coffee-and-telesense/PicoAPRS/kicad/firmware-edition/firmware-edition.kicad_pcb

## KiCad design kicad/firmware-edition/firmware-edition.kicad_pcb (2025-06-20)

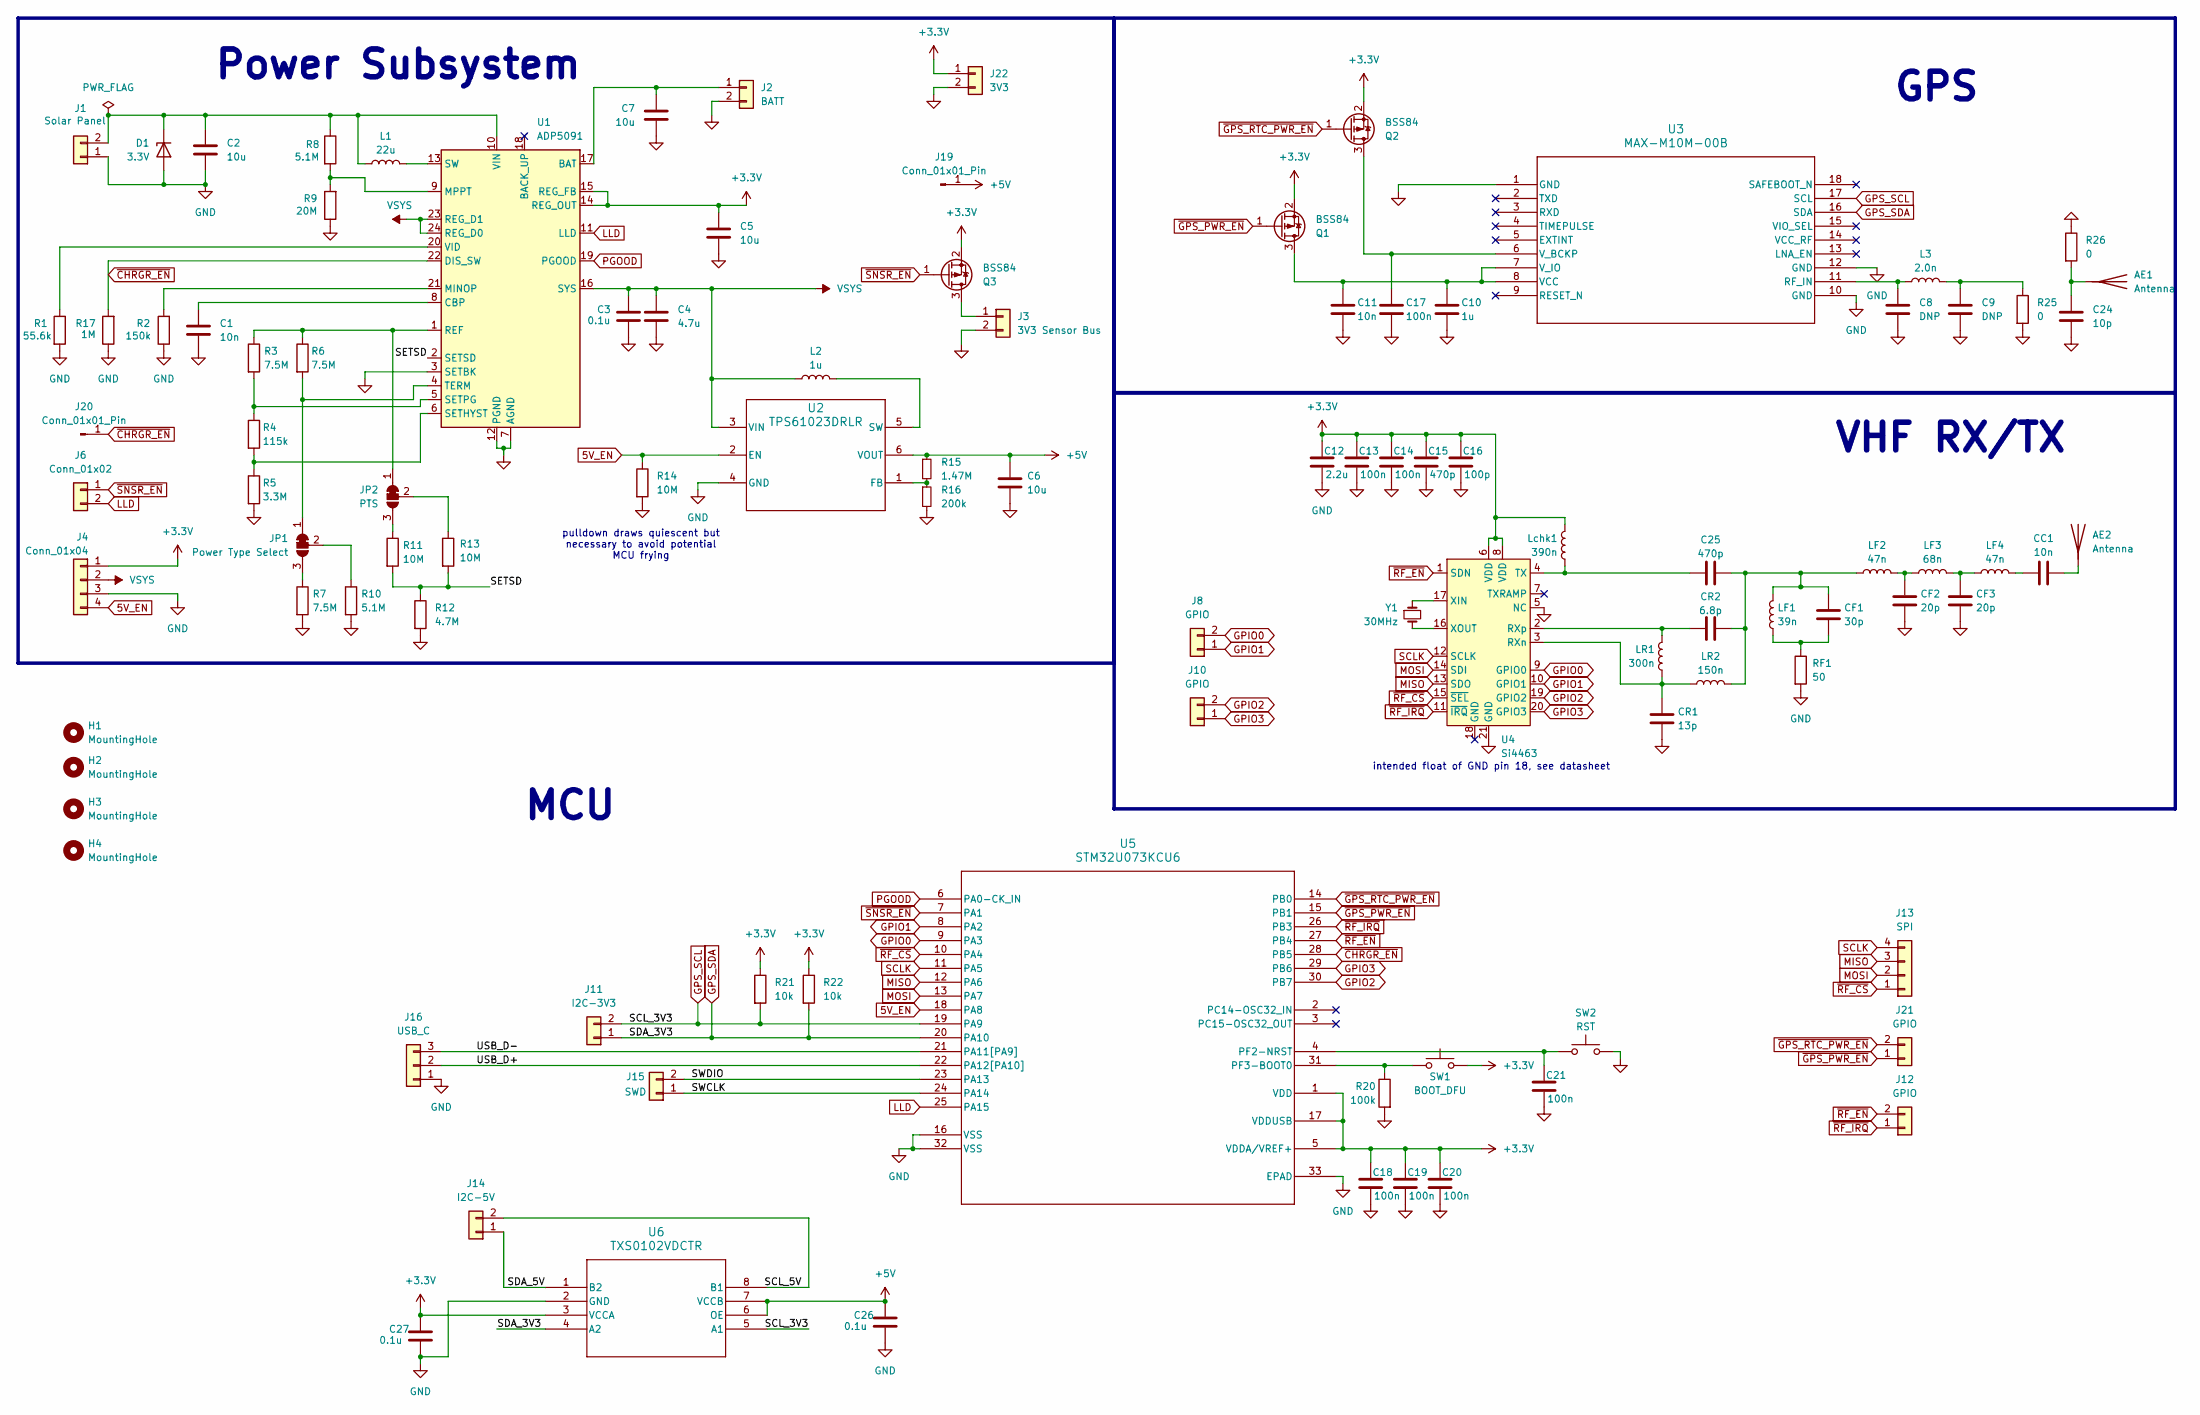
[picture p1: schematic firmware-edition.kicad_sch]

Parts:
AE1: Antenna; AC30157-01 GNSS Ceramic Chip
AE2: Antenna; SolderWirePad_1x01_SMD_1x2mm
C1, C11: 10n; C_0603_1608Metric
C2, C5, C6, C7: 10u; C_0603_1608Metric
C3, C26, C27: 0.1u; C_0603_1608Metric
C4: 4.7u; C_0603_1608Metric
C8, C9: DNP; C_0603_1608Metric
C10: 1u; C_0603_1608Metric
C12: 2.2u; C_0603_1608Metric
C13, C14, C17, C18, C19, C20, C21: 100n; C_0603_1608Metric
C15, C25: 470p; C_0603_1608Metric
C16: 100p; C_0603_1608Metric
C24: 10p; C_0603_1608Metric
CC1: 10n; C_0603_1608Metric
CF1: 30p; C_0603_1608Metric
CF2, CF3: 20p; C_0603_1608Metric
CR1: 13p; C_0603_1608Metric
CR2: 6.8p; C_0603_1608Metric
D1: 3.3V; D_0402_1005Metric_Pad0.77x0.64mm_HandSolder
H1, H2, H3, H4: MountingHole; MountingHole_3.2mm_M3_ISO14580
J1: Solar Panel; PinSocket_1x02_P2.54mm_Vertical
J2: BATT; PinSocket_1x02_P2.54mm_Vertical
J3: 3V3 Sensor Bus; PinSocket_1x02_P2.54mm_Vertical
J4: Conn_01x04; PinHeader_1x04_P2.54mm_Vertical
J6: Conn_01x02; PinHeader_1x02_P2.54mm_Vertical
J8, J10, J12, J21: GPIO; PinHeader_1x02_P2.54mm_Vertical
J11: I2C-3V3; PinHeader_1x02_P2.54mm_Vertical
J13: SPI; PinHeader_1x04_P2.54mm_Vertical
J14: I2C-5V; PinHeader_1x02_P2.54mm_Vertical
J15: SWD; PinHeader_1x02_P2.54mm_Vertical
J16: USB_C; PinHeader_1x03_P2.54mm_Vertical
J19, J20: Conn_01x01_Pin; PinHeader_1x01_P2.54mm_Vertical
J22: 3V3; PinSocket_1x02_P2.54mm_Vertical
JP1: Power Type Select; SolderJumper-3_P1.3mm_Bridged12_Pad1.0x1.5mm
JP2: PTS; SolderJumper-3_P1.3mm_Bridged12_Pad1.0x1.5mm
L1: 22u; L_Vishay_IFSC-1515AH_4x4x1.8mm
L2: 1u; L_0603_1608Metric
L3: 2.0n; L_0603_1608Metric
LF1: 39n; L_0603_1608Metric
LF2, LF4: 47n; L_0603_1608Metric
LF3: 68n; L_0603_1608Metric
LR1: 300n; L_0603_1608Metric
LR2: 150n; L_0603_1608Metric
Lchk1: 390n; L_0603_1608Metric
Q1, Q2, Q3: BSS84; SOT-23
R1: 55.6k; R_0603_1608Metric
R2: 150k; R_0603_1608Metric
R3, R6, R7: 7.5M; R_0603_1608Metric
R4: 115k; R_0603_1608Metric
R5: 3.3M; R_0603_1608Metric
R8, R10: 5.1M; R_0603_1608Metric
R9: 20M; R_0603_1608Metric
R11, R13, R14: 10M; R_0603_1608Metric
R12: 4.7M; R_0603_1608Metric
R15: 1.47M; R_0603_1608Metric
R16: 200k; R_0603_1608Metric
R17: 1M; R_0603_1608Metric
R20: 100k; R_0603_1608Metric
R21, R22: 10k; R_0603_1608Metric
R25, R26: 0; R_0603_1608Metric
RF1: 50; R_0603_1608Metric
SW1: BOOT_DFU; SW_Push_1TS009xxxx-xxxx-xxxx_6x6x5mm
SW2: RST; SW_Push_1TS009xxxx-xxxx-xxxx_6x6x5mm
U1: ADP5091; LFCSP-24-1EP_4x4mm_P0.5mm_EP2.3x2.3mm
U2: TPS61023DRLR; DRL0006A
U3: MAX-M10M-00B; MOD18_MAX-M10M_UBL
U4: Si4463; QFN-20-1EP_4x4mm_P0.5mm_EP2.6x2.6mm
U5: STM32U073KCU6; UFQFPN-32_STM
U6: TXS0102VDCTR; SSOP8_DCT_TEX
Y1: 30MHz; Crystal_SMD_Abracon_ABM3-2Pin_5.0x3.2mm

Connections:
5V_EN: J4.4, R14.1, U2.2 (EN), U5.18 (PA8)
+3.3V: C5.1, C12.1, C13.1, C14.1, C15.1, C16.1, C18.1, C19.1, C20.1, C27.1, J4.1, J22.1, Lchk1.1, Q1.2 (S), Q2.2 (S), Q3.2 (S), R21.1, R22.1, SW1.2, U1.14 (REG_OUT), U1.15 (REG_FB), U4.6 (VDD), U4.8 (VDD), U5.1 (VDD), U5.5 (VDDA/VREF+), U5.17 (VDDUSB), U6.3 (VCCA); also elsewhere on the board
+5V: C6.1, C26.1, J19.1, R15.1, U2.6 (VOUT), U6.6 (OE), U6.7 (VCCB)
/SCL_5V: J14.2, U6.8 (B1)
/SDA_5V: J14.1, U6.1 (B2)
/SETSD: R11.2, R12.1, R13.2, U1.2 (SETSD)
/SWCLK: J15.1, U5.24 (PA14)
/SWDIO: J15.2, U5.23 (PA13)
/USB_D+: J16.2, U5.22 (PA12[PA10])
/USB_D-: J16.3, U5.21 (PA11[PA9])
GND: C1.2, C2.2, C3.2, C4.2, C5.2, C6.2, C7.2, C8.2, C9.2, C10.2, C11.2, C12.2, C13.2, C14.2, C15.2, C16.2, C17.2, C18.2, C19.2, C20.2, C21.2, C24.2, C26.2, C27.2, CF2.2, CF3.2, CR1.2, D1.2 (A), J1.1, J2.2, J3.2, J4.3, J16.1, J22.2, R1.2, R2.1, R5.2, R7.2, R9.1, R10.2, R12.2, R14.2, R16.2, R17.1, R20.2, R25.2, R26.1, RF1.2, SW2.2, U1.3 (SETBK), U1.7 (AGND), U1.12 (PGND), U1.25 (AGND), U2.4 (GND), U3.1 (GND), U3.10 (GND), U3.12 (GND), U4.5 (NC), U4.21 (GND), U5.16 (VSS), U5.32 (VSS), U5.33 (EPAD), U5.34, U6.2 (GND); also elsewhere on the board
GPIO0: J8.2, U4.9 (GPIO0), U5.9 (PA3)
GPIO1: J8.1, U4.10 (GPIO1), U5.8 (PA2)
GPIO2: J10.2, U4.19 (GPIO2), U5.30 (PB7)
GPIO3: J10.1, U4.20 (GPIO3), U5.29 (PB6)
GPS_SCL: J11.2, R21.2, U3.17 (SCL), U5.19 (PA9), U6.5 (A1)
GPS_SDA: J11.1, R22.2, U3.16 (SDA), U5.20 (PA10), U6.4 (A2)
LLD: J6.2, U1.11 (LLD), U5.25 (PA15)
MISO: J13.3, U4.13 (SDO), U5.12 (PA6)
MOSI: J13.2, U4.14 (SDI), U5.13 (PA7)
unnamed: AE1.1 (A), C24.1, R26.2
unnamed: AE2.1 (A), CC1.2
unnamed: C9.1, L3.1, R25.1
unnamed: C25.2, CF1.1, CR2.2, LF1.2, LF2.1, LR2.2
unnamed: CC1.1, LF4.2
unnamed: CF1.2, LF1.1, RF1.1
unnamed: CF2.1, LF2.2, LF3.1
unnamed: CF3.1, LF3.2, LF4.1
unnamed: C2.1, D1.1 (K), J1.2, L1.1, R8.1, U1.10 (VIN)
unnamed: C7.1, J2.1, U1.17 (BAT)
unnamed: J3.1, Q3.3 (D)
unnamed: JP1.1 (A), R6.2, U1.4 (TERM)
unnamed: JP1.3 (B), R7.1
unnamed: JP1.2 (C), R10.1
unnamed: JP2.1 (A), R3.1, R6.1, U1.1 (REF)
unnamed: JP2.3 (B), R11.1
unnamed: JP2.2 (C), R13.1
unnamed: C10.1, C11.1, Q1.3 (D), U3.7 (V_IO), U3.8 (VCC)
unnamed: C17.1, Q2.3 (D), U3.6 (V_BCKP)
unnamed: C1.1, U1.8 (CBP)
unnamed: R2.2, U1.21 (MINOP)
unnamed: R8.2, R9.2, U1.9 (MPPT)
unnamed: R4.2, R5.1, U1.6 (SETHYST)
unnamed: R3.2, R4.1, U1.5 (SETPG)
unnamed: L1.2, U1.13 (SW)
unnamed: R1.1, U1.20 (VID)
unnamed: R15.2, R16.1, U2.1 (FB)
unnamed: L2.2, U2.5 (SW)
unnamed: C8.1, L3.2, U3.11 (RF_IN)
unnamed: CR1.1, LR1.2, LR2.1, U4.3 (RXn)
unnamed: CR2.1, LR1.1, U4.2 (RXp)
unnamed: C25.1, Lchk1.2, U4.4 (TX)
unnamed: U4.17 (XIN), Y1.1
unnamed: U4.16 (XOUT), Y1.2
unnamed: C21.1, SW2.1, U5.4 (PF2-NRST)
unnamed: R20.1, SW1.1, U5.31 (PF3-BOOT0)
PGOOD: U1.19 (PGOOD), U5.6 (PA0-CK_IN)
SCLK: J13.4, U4.12 (SCLK), U5.11 (PA5)
VSYS: C3.1, C4.1, J4.2, L2.1, U1.16 (SYS), U1.23 (REG_D1), U1.24 (REG_D0), U2.3 (VIN)
~CHRGR_EN: J20.1, R17.2, U1.22 (DIS_SW), U5.28 (PB5)
~GPS_PWR_EN: J21.1, Q1.1 (G), U5.15 (PB1)
~GPS_RTC_PWR_EN: J21.2, Q2.1 (G), U5.14 (PB0)
~RF_CS: J13.1, U4.15 (~SEL), U5.10 (PA4)
~RF_EN: J12.2, U4.1 (SDN), U5.27 (PB4)
~RF_IRQ: J12.1, U4.11 (~IRQ), U5.26 (PB3)
~SNSR_EN: J6.1, Q3.1 (G), U5.7 (PA1)

Notes on the sheet:
intended float of GND pin 18, see datasheet
GPS
Power Subsystem
MCU
VHF RX/TX
pulldown draws quiescent but necessary to avoid potential MCU frying

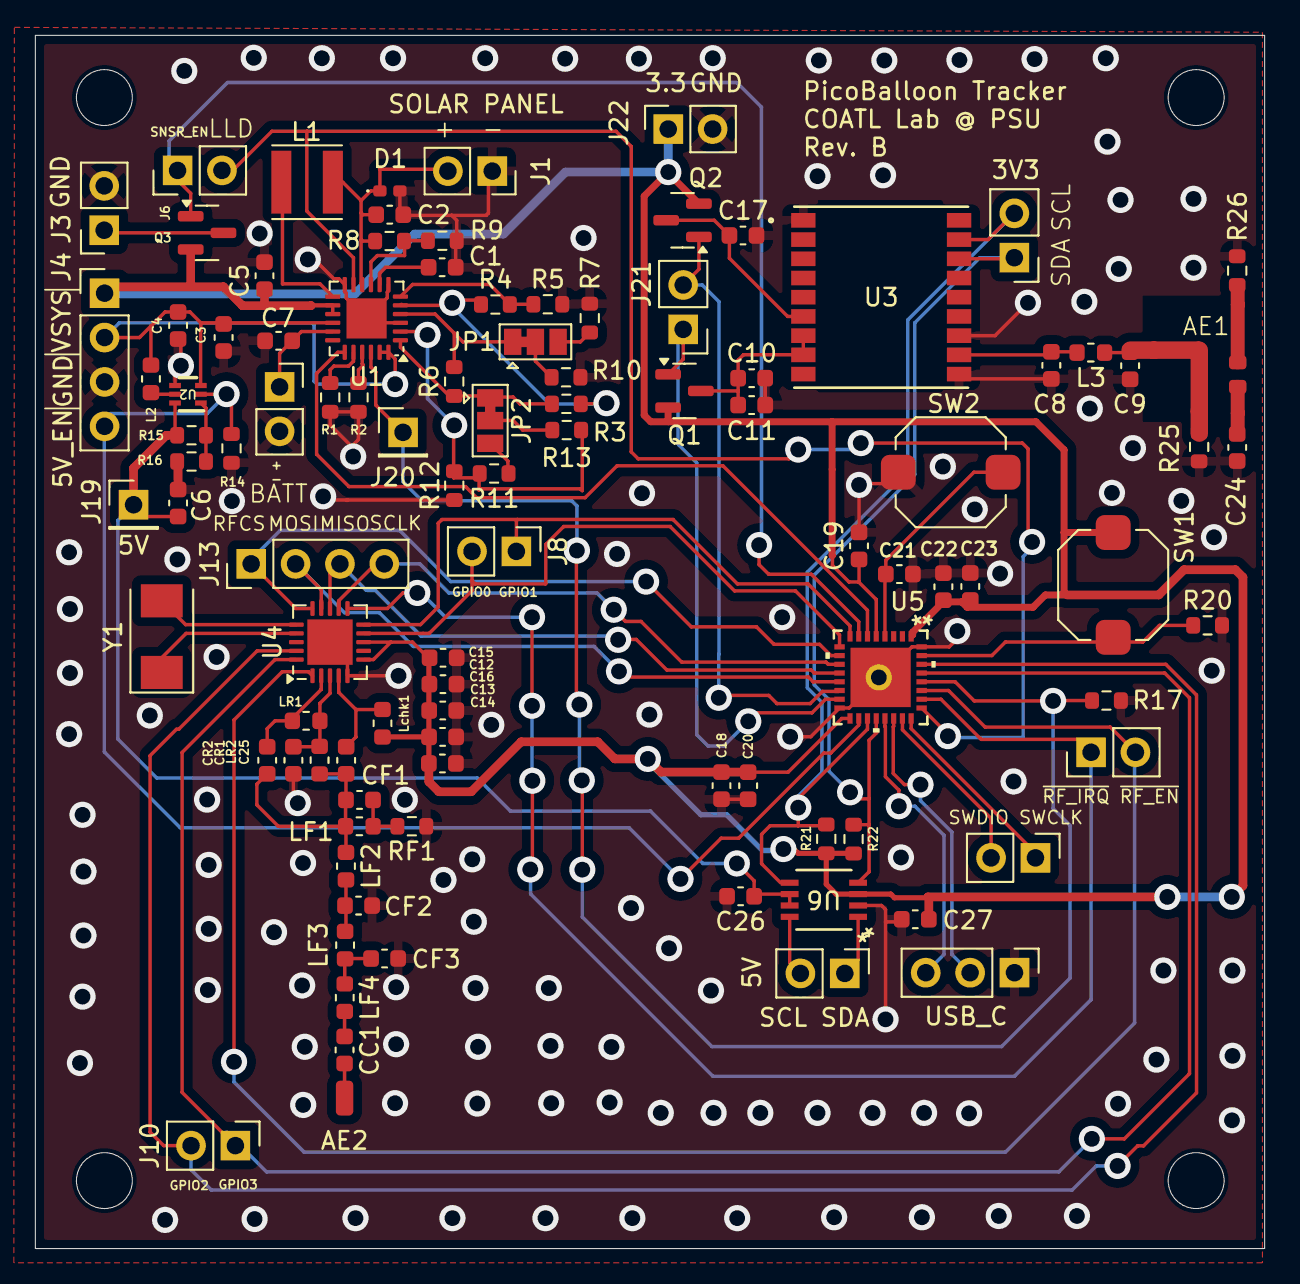
[picture p2: board firmware-edition.kicad_pcb from above]

Board: 2 copper layers, 70.4 x 69.4 mm, 104 parts (0 on the bottom side), 66 nets.

Other parts of the board:
C22, C23: 100n; C_0603_1608Metric

Their connections:
+3.3V: C22.1, C23.1; also elsewhere on the board
GND: C22.2, C23.2; also elsewhere on the board
