coffee-and-telesense/PicoAPRS/kicad/stm32u073-breakout/stm32u073-breakout.kicad_pcb

## KiCad design kicad/stm32u073-breakout/stm32u073-breakout.kicad_pcb (2025-05-19)

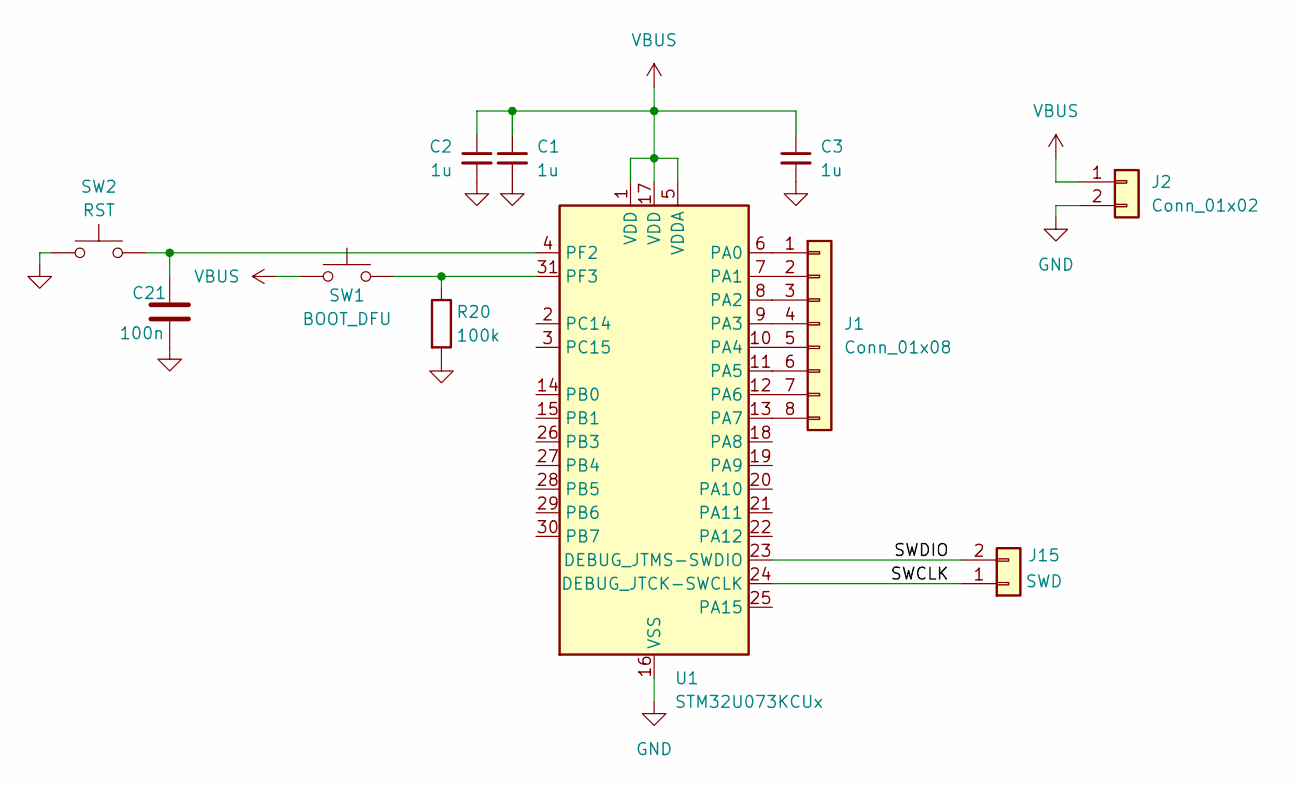
[picture p3: schematic stm32u073-breakout.kicad_sch]

Parts:
C1, C2, C3: 1u; C_0603_1608Metric
C21: 100n; C_0603_1608Metric
J1: Conn_01x08; PinHeader_1x08_P2.54mm_Vertical
J2: Conn_01x02; PinHeader_1x02_P2.54mm_Vertical
J15: SWD; PinHeader_1x02_P2.54mm_Vertical
R20: 100k; R_0603_1608Metric
SW1: BOOT_DFU; SW_SPST_B3S-1000
SW2: RST; SW_SPST_B3S-1000
U1: STM32U073KCUx; QFN-32-1EP_5x5mm_P0.5mm_EP3.45x3.45mm

Connections:
/SWCLK: J15.1, U1.24 (DEBUG_JTCK-SWCLK)
/SWDIO: J15.2, U1.23 (DEBUG_JTMS-SWDIO)
GND: C1.2, C2.2, C3.2, C21.2, J2.2, R20.2, SW2.2, U1.16 (VSS), U1.32 (VSS), U1.33 (VSS)
unnamed: J1.1, U1.6 (PA0)
unnamed: J1.2, U1.7 (PA1)
unnamed: J1.3, U1.8 (PA2)
unnamed: J1.4, U1.9 (PA3)
unnamed: J1.5, U1.10 (PA4)
unnamed: J1.6, U1.11 (PA5)
unnamed: J1.7, U1.12 (PA6)
unnamed: J1.8, U1.13 (PA7)
unnamed: C21.1, SW2.1, U1.4 (PF2)
unnamed: R20.1, SW1.1, U1.31 (PF3)
VBUS: C1.1, C2.1, C3.1, J2.1, SW1.2, U1.1 (VDD), U1.5 (VDDA), U1.17 (VDD)

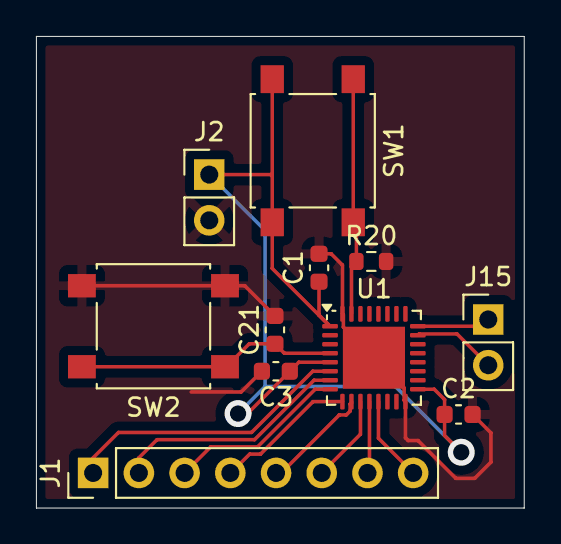
[picture p4: board stm32u073-breakout.kicad_pcb from above]

Board: 2 copper layers, 27.1 x 26.2 mm, 11 parts (0 on the bottom side), 14 nets.
