coffee-and-telesense/PicoAPRS/kicad/USB-C breakout board/USBC_Breakoutboard/USBC_Breakoutboard.kicad_pcb

## KiCad design kicad/USB-C breakout board/USBC_Breakoutboard/USBC_Breakoutboard.kicad_pcb (2025-05-17)

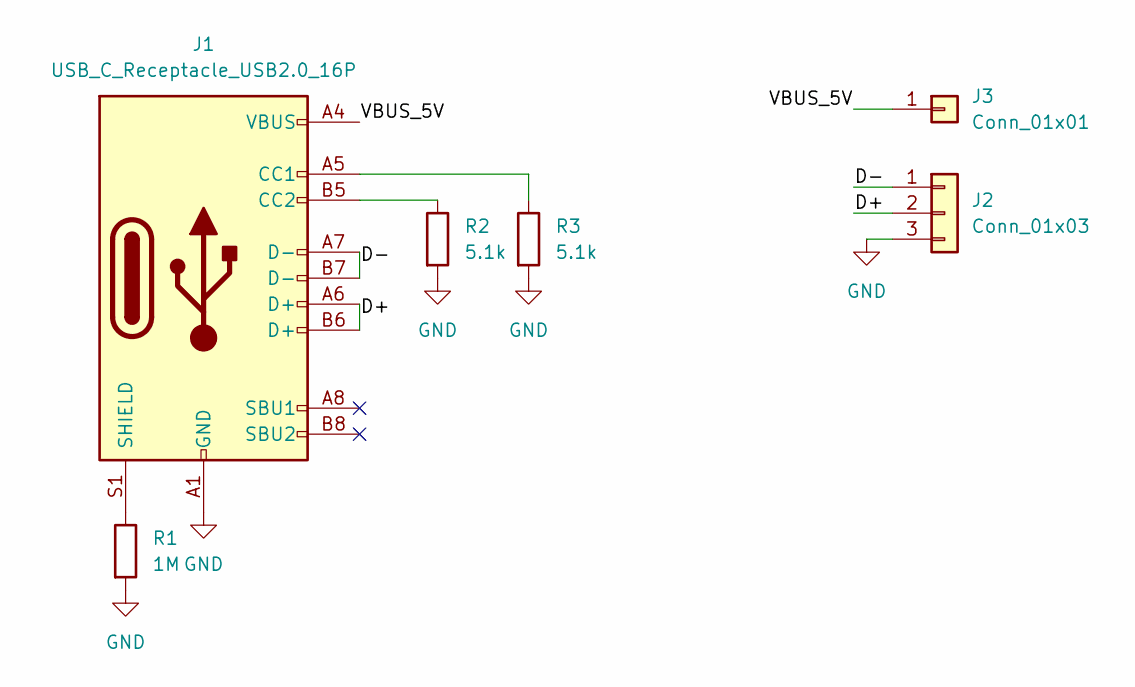
[picture p5: schematic USBC_Breakoutboard.kicad_sch]

Parts:
J1: USB_C_Receptacle_USB2.0_16P; USB_C_Receptacle_GCT_USB4105-xx-A_16P_TopMnt_Horizontal
J2: Conn_01x03; PinHeader_1x03_P2.54mm_Vertical
J3: Conn_01x01; PinHeader_1x01_P2.54mm_Vertical
R1: 1M; R_0603_1608Metric
R2, R3: 5.1k; R_0603_1608Metric

Connections:
/D+: J1.A6 (D+), J1.B6 (D+), J2.2
/D-: J1.A7 (D-), J1.B7 (D-), J2.1
/VBUS_5V: J1.A4 (VBUS), J1.A9 (VBUS), J1.B4 (VBUS), J1.B9 (VBUS), J3.1
GND: J1.A1 (GND), J1.A12 (GND), J1.B1 (GND), J1.B12 (GND), J2.3, R1.2, R2.2, R3.2
unnamed: J1.A5 (CC1), R3.1
unnamed: J1.B5 (CC2), R2.1
unnamed: J1.S1 (SHIELD), R1.1

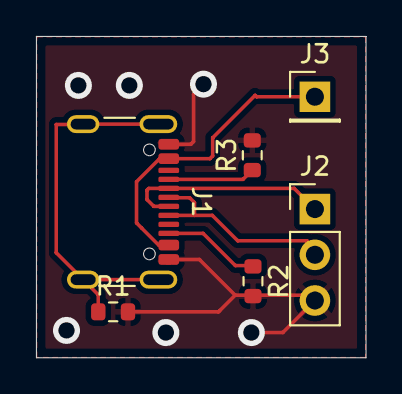
[picture p6: board USBC_Breakoutboard.kicad_pcb from above]

Board: 2 copper layers, 18.3 x 17.9 mm, 6 parts (0 on the bottom side), 7 nets.
