coffee-and-telesense/PicoAPRS/kicad/rf0603/rf-frontend-test.kicad_pcb

## KiCad design kicad/rf0603/rf-frontend-test.kicad_pcb (2025-04-23)

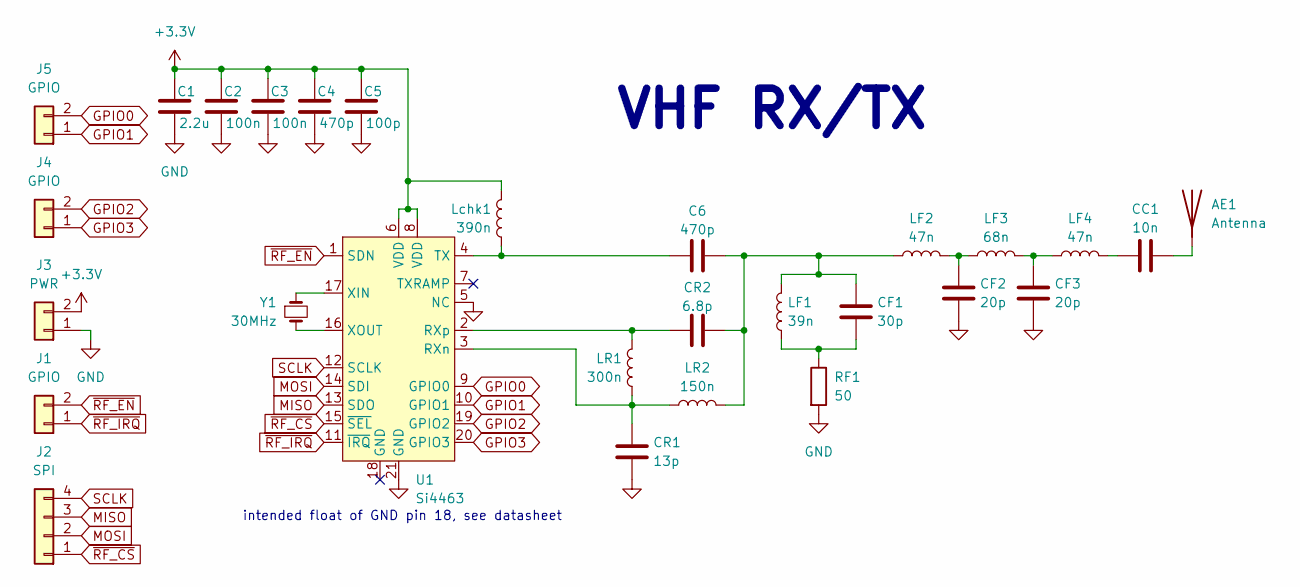
[picture p7: schematic rf-frontend-test.kicad_sch]

Parts:
AE1: Antenna; SolderWirePad_1x01_SMD_1x2mm
C1: 2.2u; C_0402_1005Metric
C2, C3: 100n; C_0402_1005Metric
C4, C6: 470p; C_0402_1005Metric
C5: 100p; C_0402_1005Metric
CC1: 10n; C_0402_1005Metric
CF1: 30p; C_0402_1005Metric
CF2, CF3: 20p; C_0402_1005Metric
CR1: 13p; C_0402_1005Metric
CR2: 6.8p; C_0402_1005Metric
J1, J4, J5: GPIO; PinHeader_1x02_P2.54mm_Vertical
J2: SPI; PinHeader_1x04_P2.54mm_Vertical
J3: PWR; PinHeader_1x02_P2.54mm_Vertical
LF1: 39n; L_0402_1005Metric
LF2, LF4: 47n; L_0402_1005Metric
LF3: 68n; L_0402_1005Metric
LR1: 300n; L_0402_1005Metric
LR2: 150n; L_0402_1005Metric
Lchk1: 390n; L_0402_1005Metric
RF1: 50; R_0402_1005Metric
U1: Si4463; QFN-20-1EP_4x4mm_P0.5mm_EP2.6x2.6mm
Y1: 30MHz; Crystal_SMD_Abracon_ABM3-2Pin_5.0x3.2mm

Connections:
+3.3V: C1.1, C2.1, C3.1, C4.1, C5.1, J3.2, Lchk1.1, U1.6 (VDD), U1.8 (VDD)
GND: C1.2, C2.2, C3.2, C4.2, C5.2, CF2.2, CF3.2, CR1.2, J3.1, RF1.2, U1.5 (NC), U1.21 (GND)
GPIO0: J5.2, U1.9 (GPIO0)
GPIO1: J5.1, U1.10 (GPIO1)
GPIO2: J4.2, U1.19 (GPIO2)
GPIO3: J4.1, U1.20 (GPIO3)
MISO: J2.3, U1.13 (SDO)
MOSI: J2.2, U1.14 (SDI)
unnamed: AE1.1 (A), CC1.2
unnamed: C6.2, CF1.1, CR2.2, LF1.2, LF2.1, LR2.2
unnamed: CC1.1, LF4.2
unnamed: CF1.2, LF1.1, RF1.1
unnamed: CF2.1, LF2.2, LF3.1
unnamed: CF3.1, LF3.2, LF4.1
unnamed: CR1.1, LR1.2, LR2.1, U1.3 (RXn)
unnamed: CR2.1, LR1.1, U1.2 (RXp)
unnamed: C6.1, Lchk1.2, U1.4 (TX)
unnamed: U1.17 (XIN), Y1.1
unnamed: U1.16 (XOUT), Y1.2
SCLK: J2.4, U1.12 (SCLK)
~RF_CS: J2.1, U1.15 (~SEL)
~RF_EN: J1.2, U1.1 (SDN)
~RF_IRQ: J1.1, U1.11 (~IRQ)

Notes on the sheet:
intended float of GND pin 18, see datasheet
VHF RX/TX

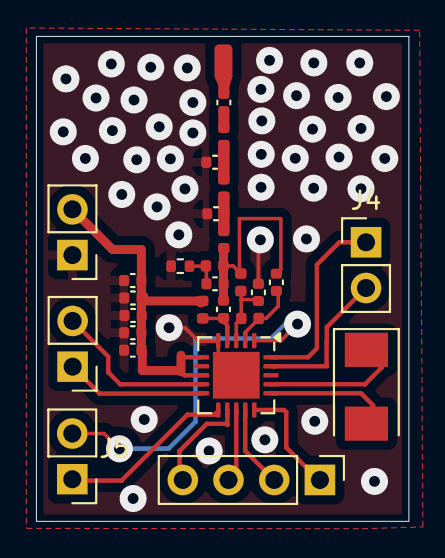
[picture p8: board rf-frontend-test.kicad_pcb from above]

Board: 2 copper layers, 20.7 x 26.9 mm, 28 parts (0 on the bottom side), 23 nets.
