coffee-and-telesense/PicoAPRS/kicad/gnss-test/gnss-test.kicad_pcb

## KiCad design kicad/gnss-test/gnss-test.kicad_pcb (2025-04-20)

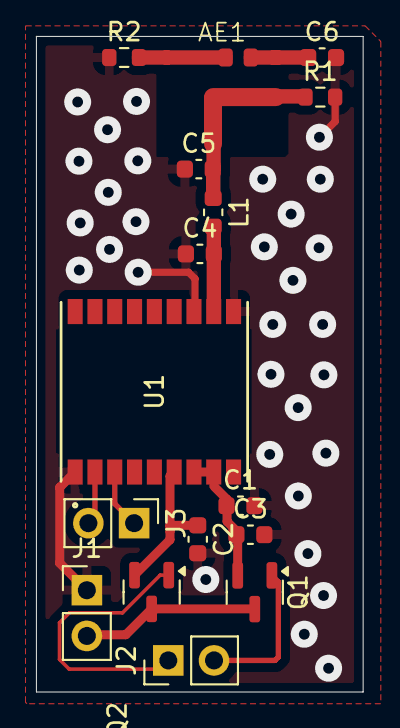
[picture p9: board gnss-test.kicad_pcb from above]

Board: 2 copper layers, 18.2 x 36.4 mm, 16 parts (0 on the bottom side), 11 nets.

Parts:
AE1: Antenna; AC30157-01 GNSS Ceramic Chip
C1: 10n; C_0603_1608Metric
C2: 100n; C_0603_1608Metric
C3: 1u; C_0603_1608Metric
C4, C5: DNP; C_0603_1608Metric
C6: 10p; C_0603_1608Metric
J1: PWR; PinHeader_1x02_P2.54mm_Vertical
J2: EN; PinHeader_1x02_P2.54mm_Vertical
J3: UART; PinHeader_1x02_P2.54mm_Vertical
L1: 2.0n; L_0603_1608Metric
Q1, Q2: BSS84; SOT-23
R1, R2: 0; R_0603_1608Metric
U1: MAX-M10M-00B; MOD18_MAX-M10M_UBL

Connections:
+3.3V: J1.2, Q1.3 (D), Q2.3 (D)
GND: C1.2, C2.2, C3.2, C4.1, C5.1, C6.2, J1.1, R1.2, R2.1, U1.1 (GND), U1.10 (GND), U1.12 (GND)
GPS_UART_RX: J3.2, U1.2 (TXD)
GPS_UART_TX: J3.1, U1.3 (RXD)
unnamed: C6.1, R2.2
unnamed: C5.2, L1.1, R1.1
unnamed: C1.1, C3.1, Q1.2 (S), U1.7 (V_IO), U1.8 (VCC)
unnamed: C2.1, Q2.2 (S), U1.6 (V_BCKP)
unnamed: C4.2, L1.2, U1.11 (RF_IN)
~GPS_PWR_EN: J2.2, Q1.1 (G)
~GPS_RTC_PWR_EN: J2.1, Q2.1 (G)
