coffee-and-telesense/PicoAPRS/kicad/payloadDorji/payloadDorji.kicad_pcb

## KiCad design kicad/payloadDorji/payloadDorji.kicad_pcb (2024-10-22)

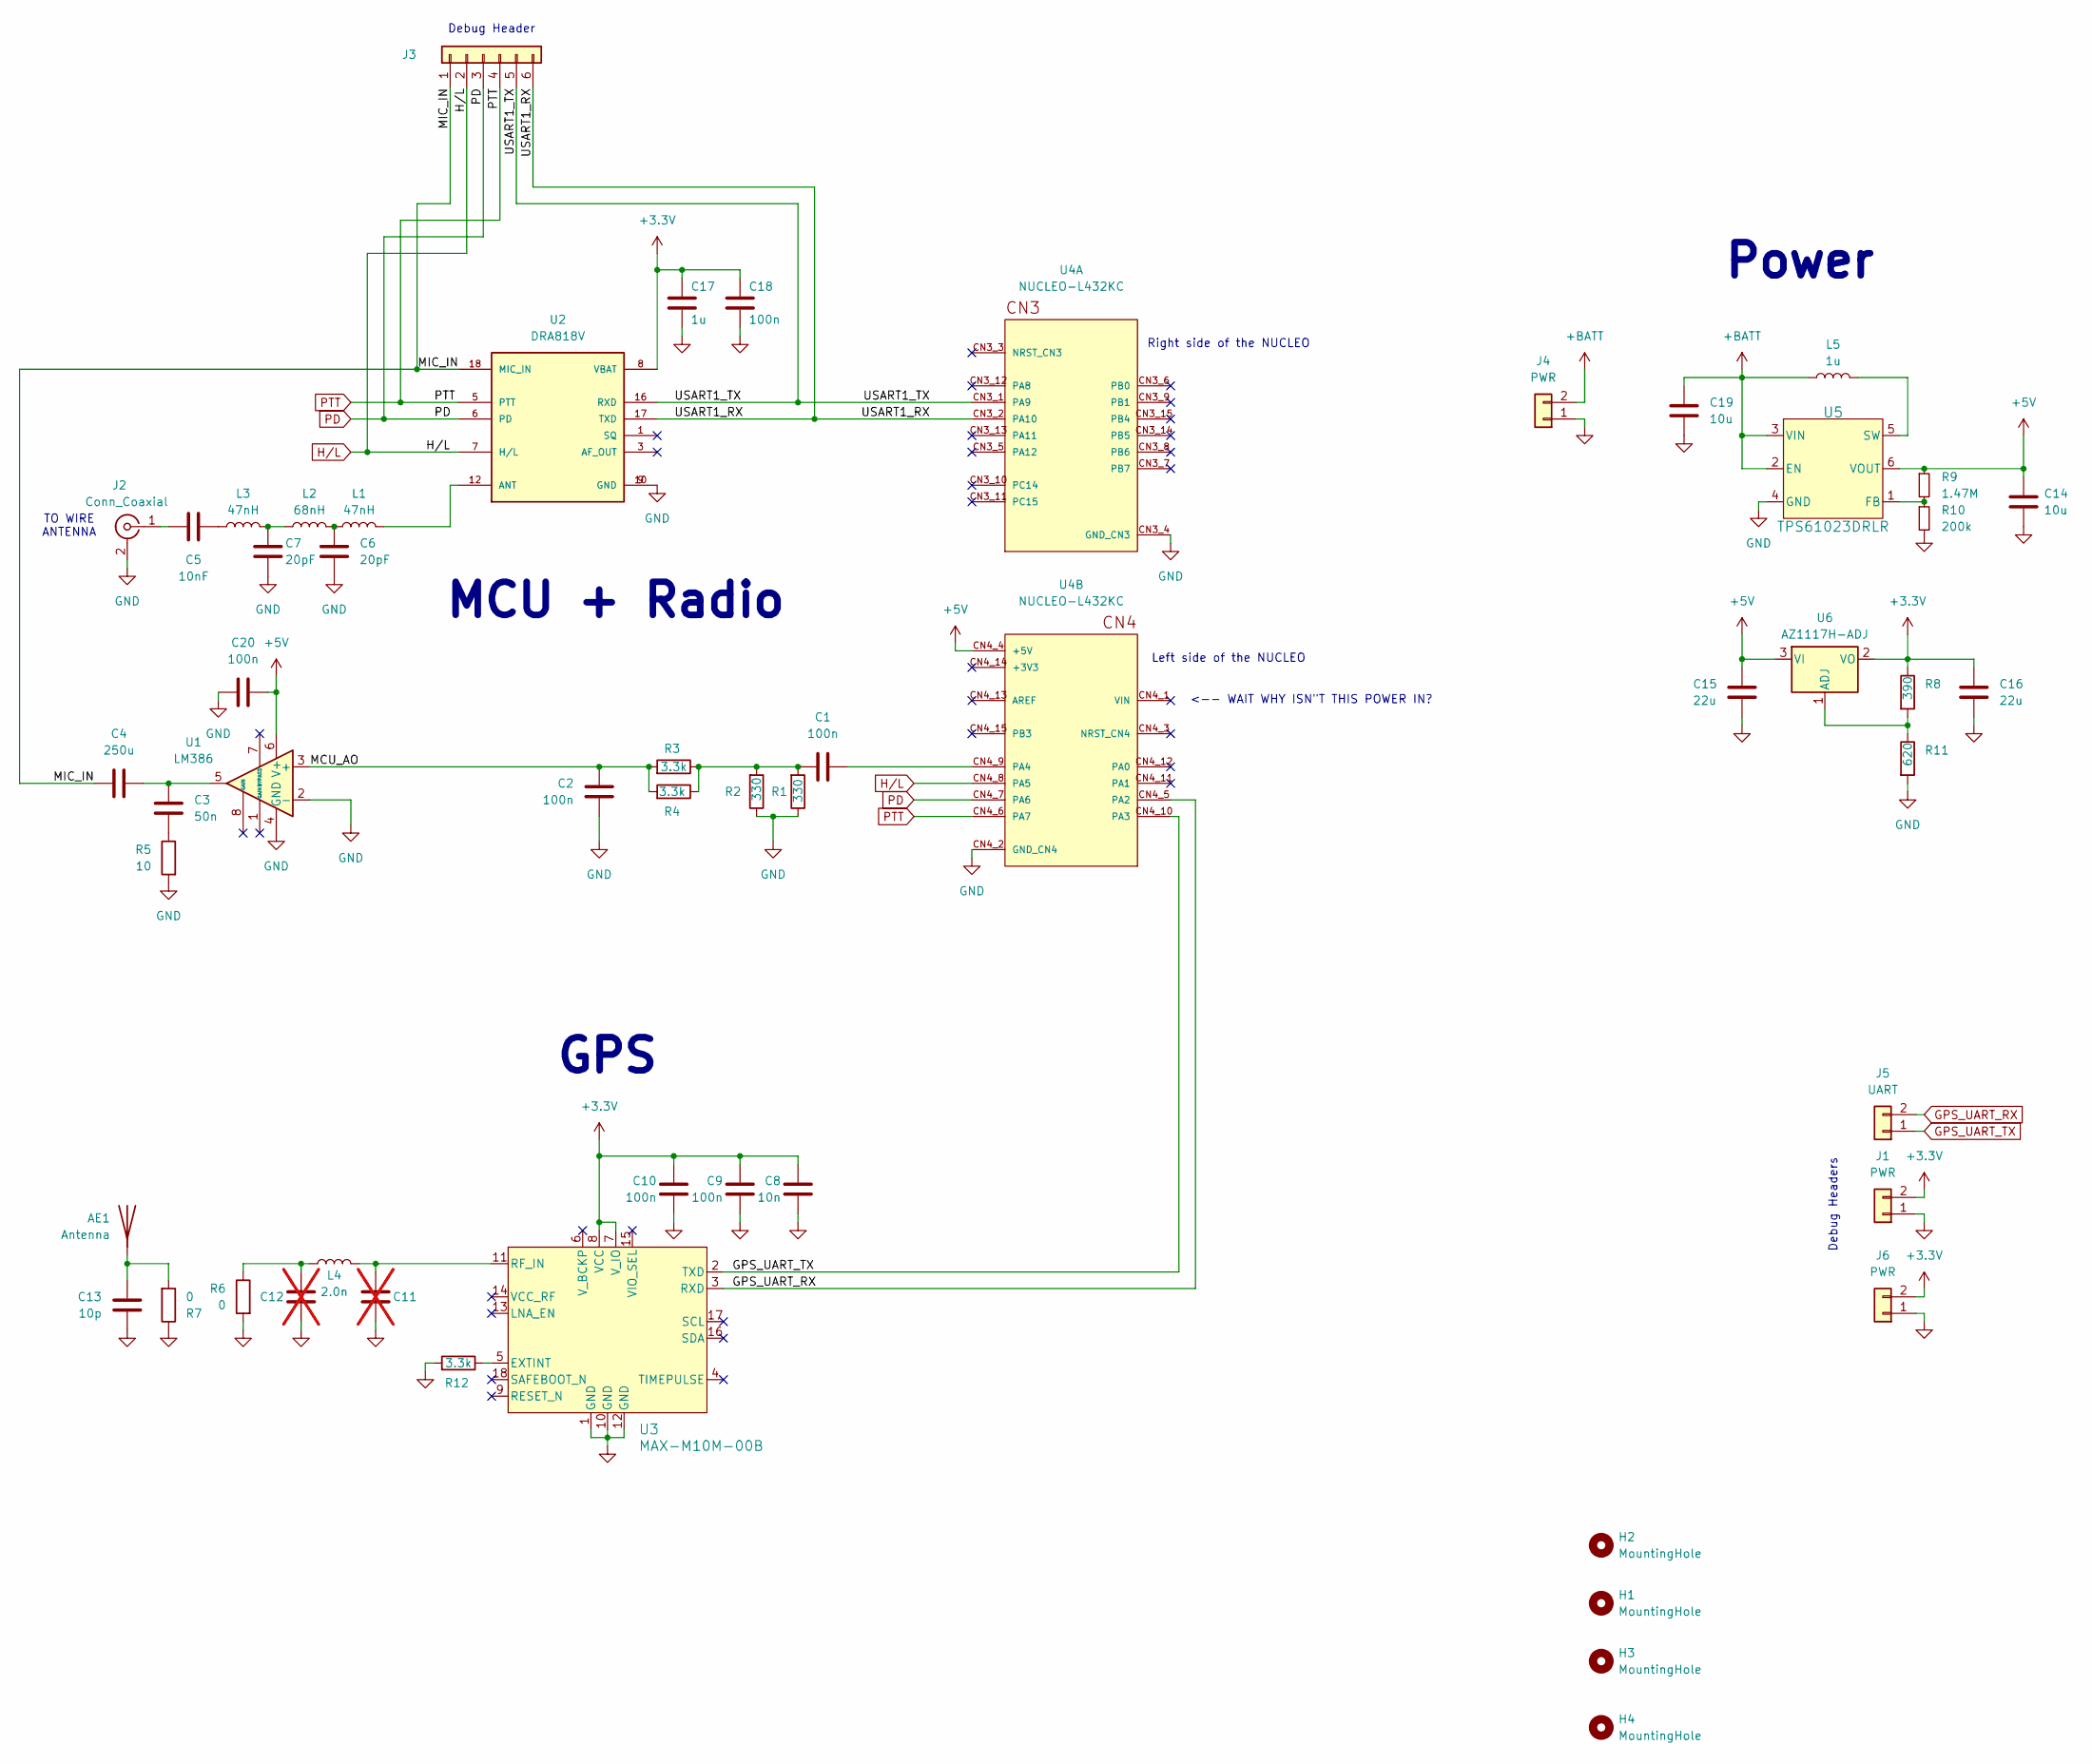
[picture p10: schematic payloadDorji.kicad_sch, PicoAPRS]

Parts:
AE1: Antenna; AC30157-01 GNSS Ceramic Chip
C1, C2, C9, C10, C18, C20: 100n; C_0603_1608Metric
C3: 50n; C_0603_1608Metric
C4: 250u; C_1210_3225Metric
C5: 10nF; C_0603_1608Metric
C6, C7: 20pF; C_0603_1608Metric
C8: 10n; C_0603_1608Metric
C11, C12: C_0603_1608Metric; not fitted
C13: 10p; C_0603_1608Metric
C14, C19: 10u; C_0603_1608Metric
C15, C16: 22u; C_0603_1608Metric
C17: 1u; C_0603_1608Metric
H1, H2, H3, H4: MountingHole; MountingHole_4.3mm_M4
J1, J4, J6: PWR; PinHeader_1x02_P2.54mm_Vertical
J2: Conn_Coaxial; SMA_Molex_73251-1153_EdgeMount_Horizontal
J3: Conn_01x06_Male; PinHeader_1x06_P2.54mm_Vertical
J5: UART; PinHeader_1x02_P2.54mm_Vertical
L1, L3: 47nH; L_0603_1608Metric
L2: 68nH; L_0603_1608Metric
L4: 2.0n; L_0603_1608Metric
L5: 1u; L_1008_2520Metric
R1, R2: 330; R_0603_1608Metric
R3, R4, R12: 3.3k; R_0603_1608Metric
R5: 10; R_0603_1608Metric
R6, R7: 0; R_0603_1608Metric
R8: 390; R_0603_1608Metric
R9: 1.47M; R_0603_1608Metric
R10: 200k; R_0603_1608Metric
R11: 620; R_0603_1608Metric
U1: LM386; DIP-8_W7.62mm_Socket
U2: DRA818V; DORJI_DRA818V; PART_REV 1.23
U3: MAX-M10M-00B; MOD18_MAX-M10M_UBL
U4: NUCLEO-L432KC; MODULE_NUCLEO-L432KC; PARTREV N/A
U5: TPS61023DRLR; DRL0006A
U6: AZ1117H-ADJ; SOT-223-3_TabPin2

Connections:
+3.3V: C8.1, C9.1, C10.1, C16.1, C17.1, C18.1, J1.2, J6.2, R8.1, U2.8 (VBAT), U3.7 (V_IO), U3.8 (VCC), U6.2 (VO)
+5V: C14.1, C15.1, C20.1, R9.1, U1.6 (V+), U4.CN4_4 (+5V), U5.6 (VOUT), U6.3 (VI)
+BATT: C19.1, J4.2, L5.1, U5.2 (EN), U5.3 (VIN)
/MCU_AO: C2.2, R3.2, R4.2, U1.3 (+)
/MIC_IN: C4.2, J3.1, U2.18 (MIC_IN)
/USART1_RX: J3.6, U2.17 (TXD), U4.CN3_2 (PA10)
/USART1_TX: J3.5, U2.16 (RXD), U4.CN3_1 (PA9)
GND: C2.1, C6.2, C7.1, C8.2, C9.2, C10.2, C11.1, C12.1, C13.2, C14.2, C15.2, C16.2, C17.2, C18.2, C19.2, C20.2, J1.1, J2.2 (Ext), J4.1, J6.1, R1.1, R2.1, R5.2, R6.2, R7.1, R10.2, R11.2, R12.2, U1.2 (-), U1.4 (GND), U2.9 (GND), U2.10 (GND), U3.1 (GND), U3.10 (GND), U3.12 (GND), U4.CN3_4 (GND_CN3), U4.CN4_2 (GND_CN4), U5.4 (GND)
GPS_UART_RX: J5.2, U3.3 (RXD), U4.CN4_5 (PA2)
GPS_UART_TX: J5.1, U3.2 (TXD), U4.CN4_10 (PA3)
H/L: J3.2, U2.7 (H/L), U4.CN4_8 (PA5)
unnamed: AE1.1 (A), C13.1, R7.2
unnamed: C1.2, R1.2, R2.2, R3.1, R4.1
unnamed: C3.1, C4.1, U1.5
unnamed: C3.2, R5.1
unnamed: C5.2, L3.1
unnamed: C6.1, L1.1, L2.2
unnamed: C7.2, L2.1, L3.2
unnamed: C12.2, L4.1, R6.1
unnamed: C5.1, J2.1 (In)
unnamed: L1.2, U2.12 (ANT)
unnamed: R12.1, U3.5 (EXTINT)
unnamed: C11.2, L4.2, U3.11 (RF_IN)
unnamed: C1.1, U4.CN4_9 (PA4)
unnamed: R9.2, R10.1, U5.1 (FB)
unnamed: L5.2, U5.5 (SW)
unnamed: R8.2, R11.1, U6.1 (ADJ)
PD: J3.3, U2.6 (PD), U4.CN4_7 (PA6)
PTT: J3.4, U2.5 (PTT), U4.CN4_6 (PA7)

Notes on the sheet:
TO WIRE ANTENNA
GPS
Left side of the NUCLEO
Right side of the NUCLEO
Power
Debug Header
Debug Headers
<-- WAIT WHY ISN"T THIS POWER IN?
MCU + Radio
