coffee-and-telesense/PicoAPRS/kicad/payloadDorji/payloadDorji.kicad_pcb

## KiCad design kicad/payloadDorji/payloadDorji.kicad_pcb (continued)

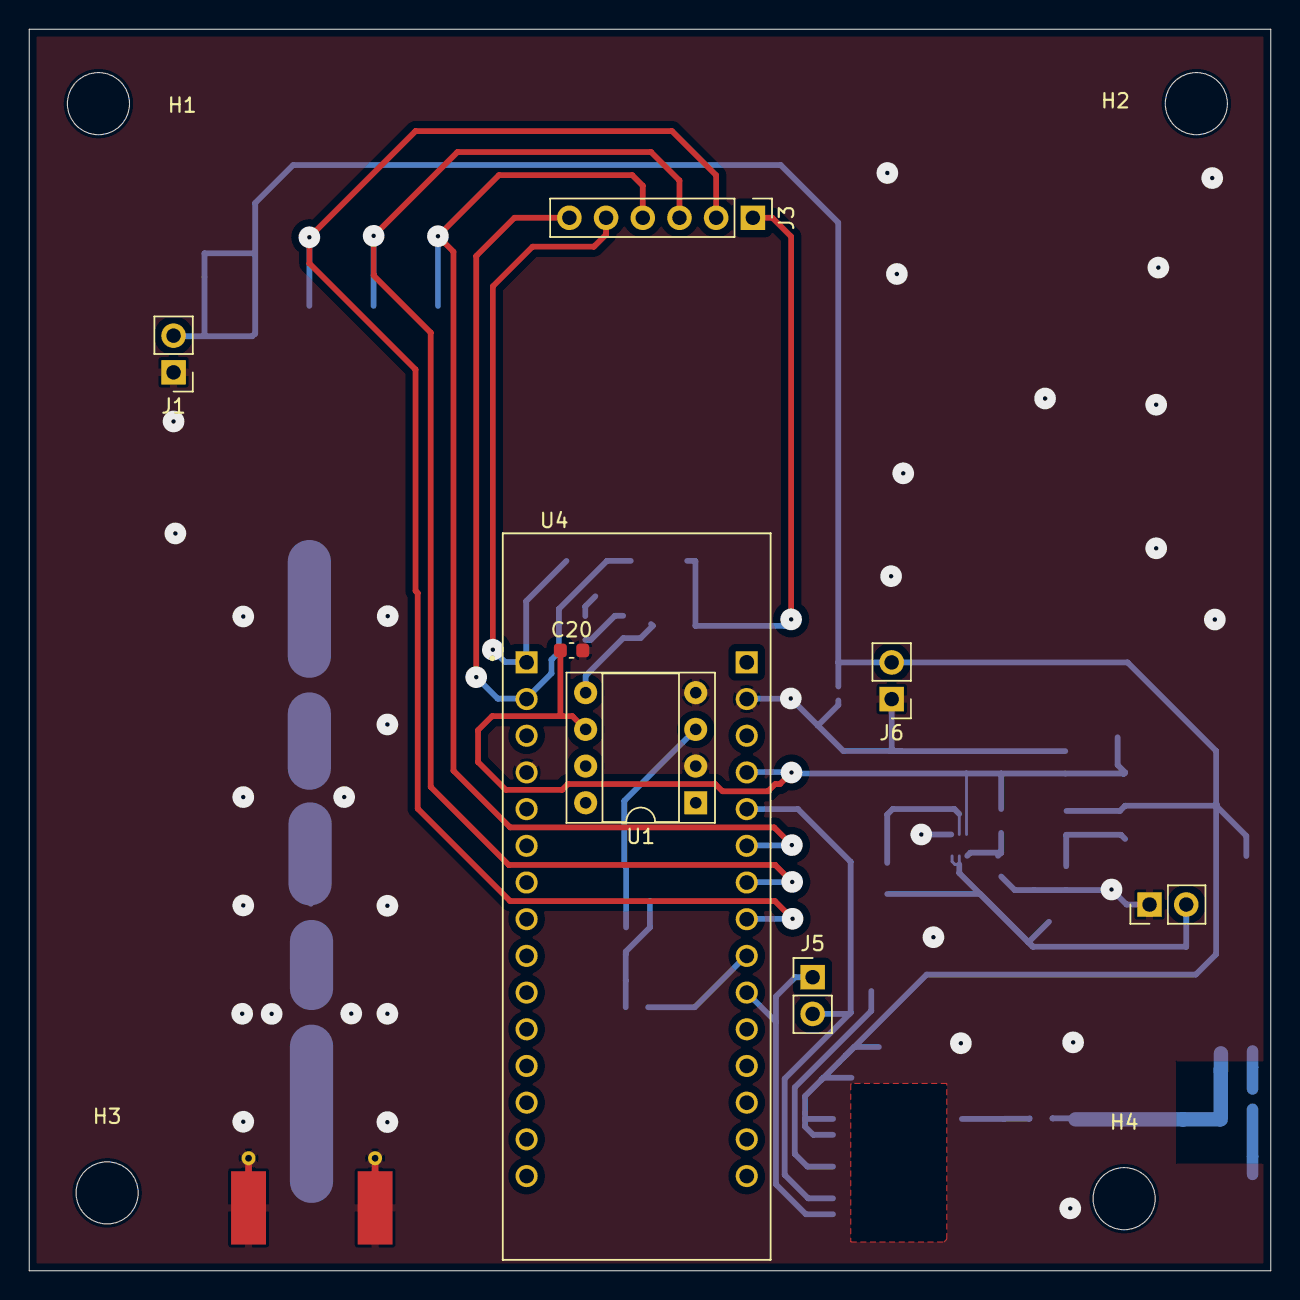
[picture p11: board payloadDorji.kicad_pcb from above]

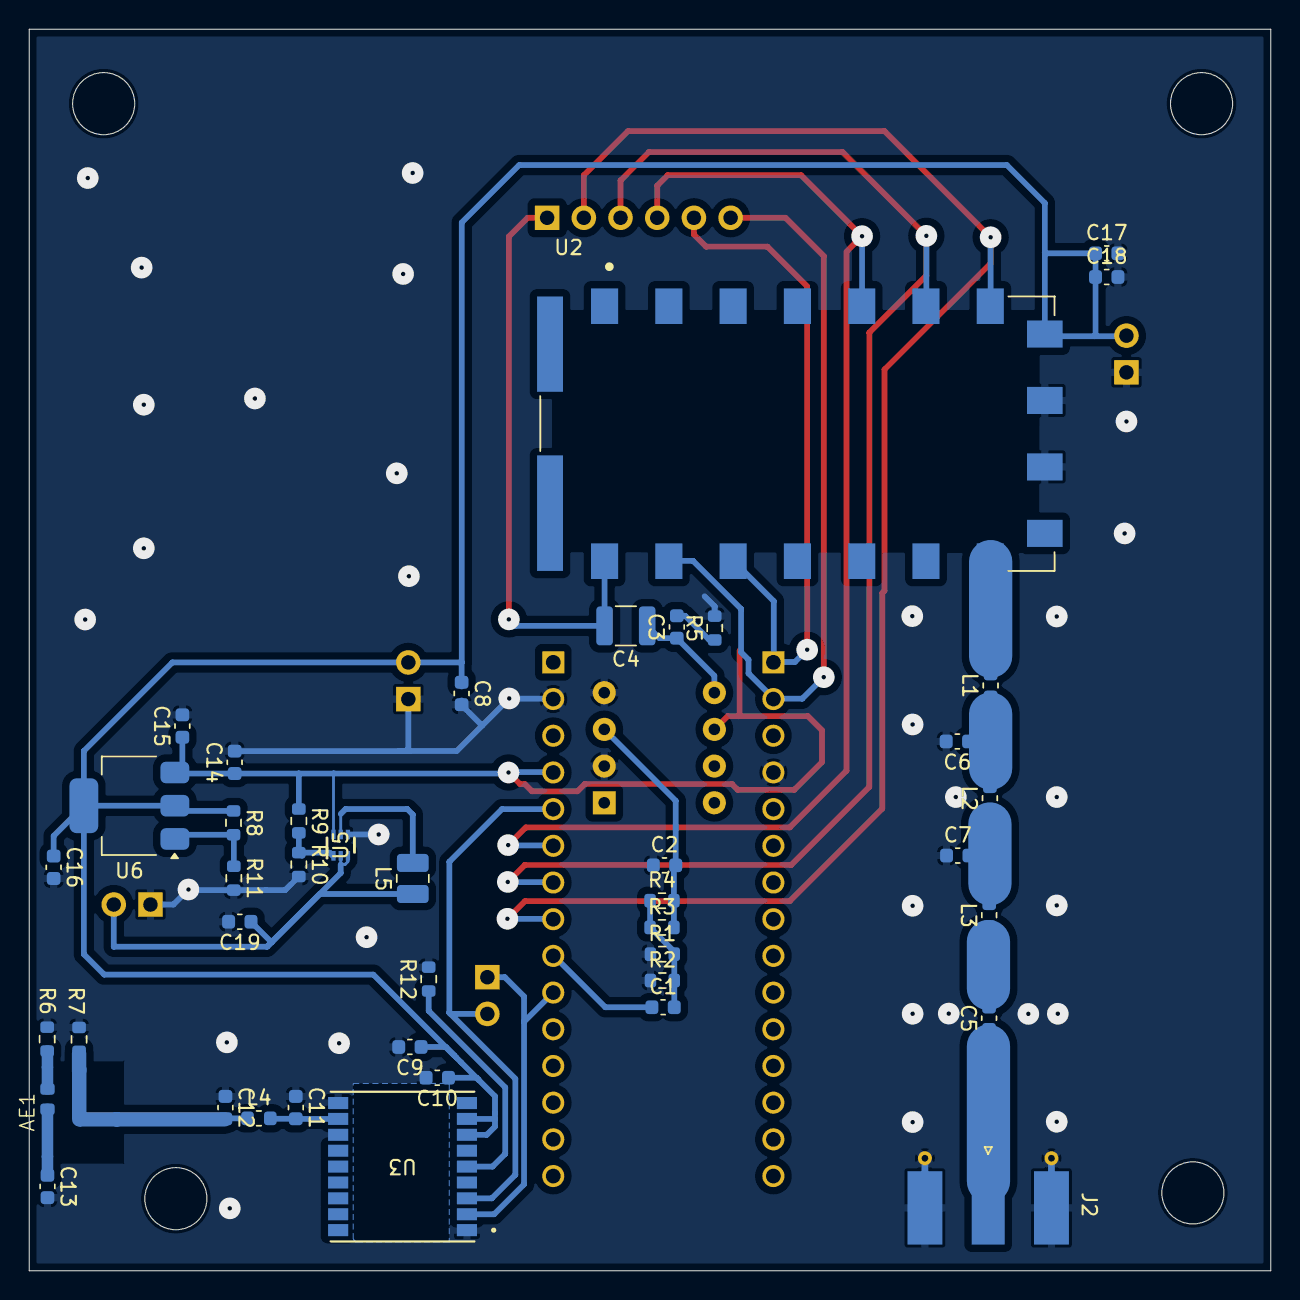
[picture p12: board payloadDorji.kicad_pcb from below]

Board: 2 copper layers, 85.9 x 85.9 mm, 54 parts (42 on the bottom side), 29 nets.
