coffee-and-telesense/PicoAPRS/kicad/dorji-gps/dorji-gps.kicad_pcb

## KiCad design kicad/dorji-gps/dorji-gps.kicad_pcb (2024-10-07)

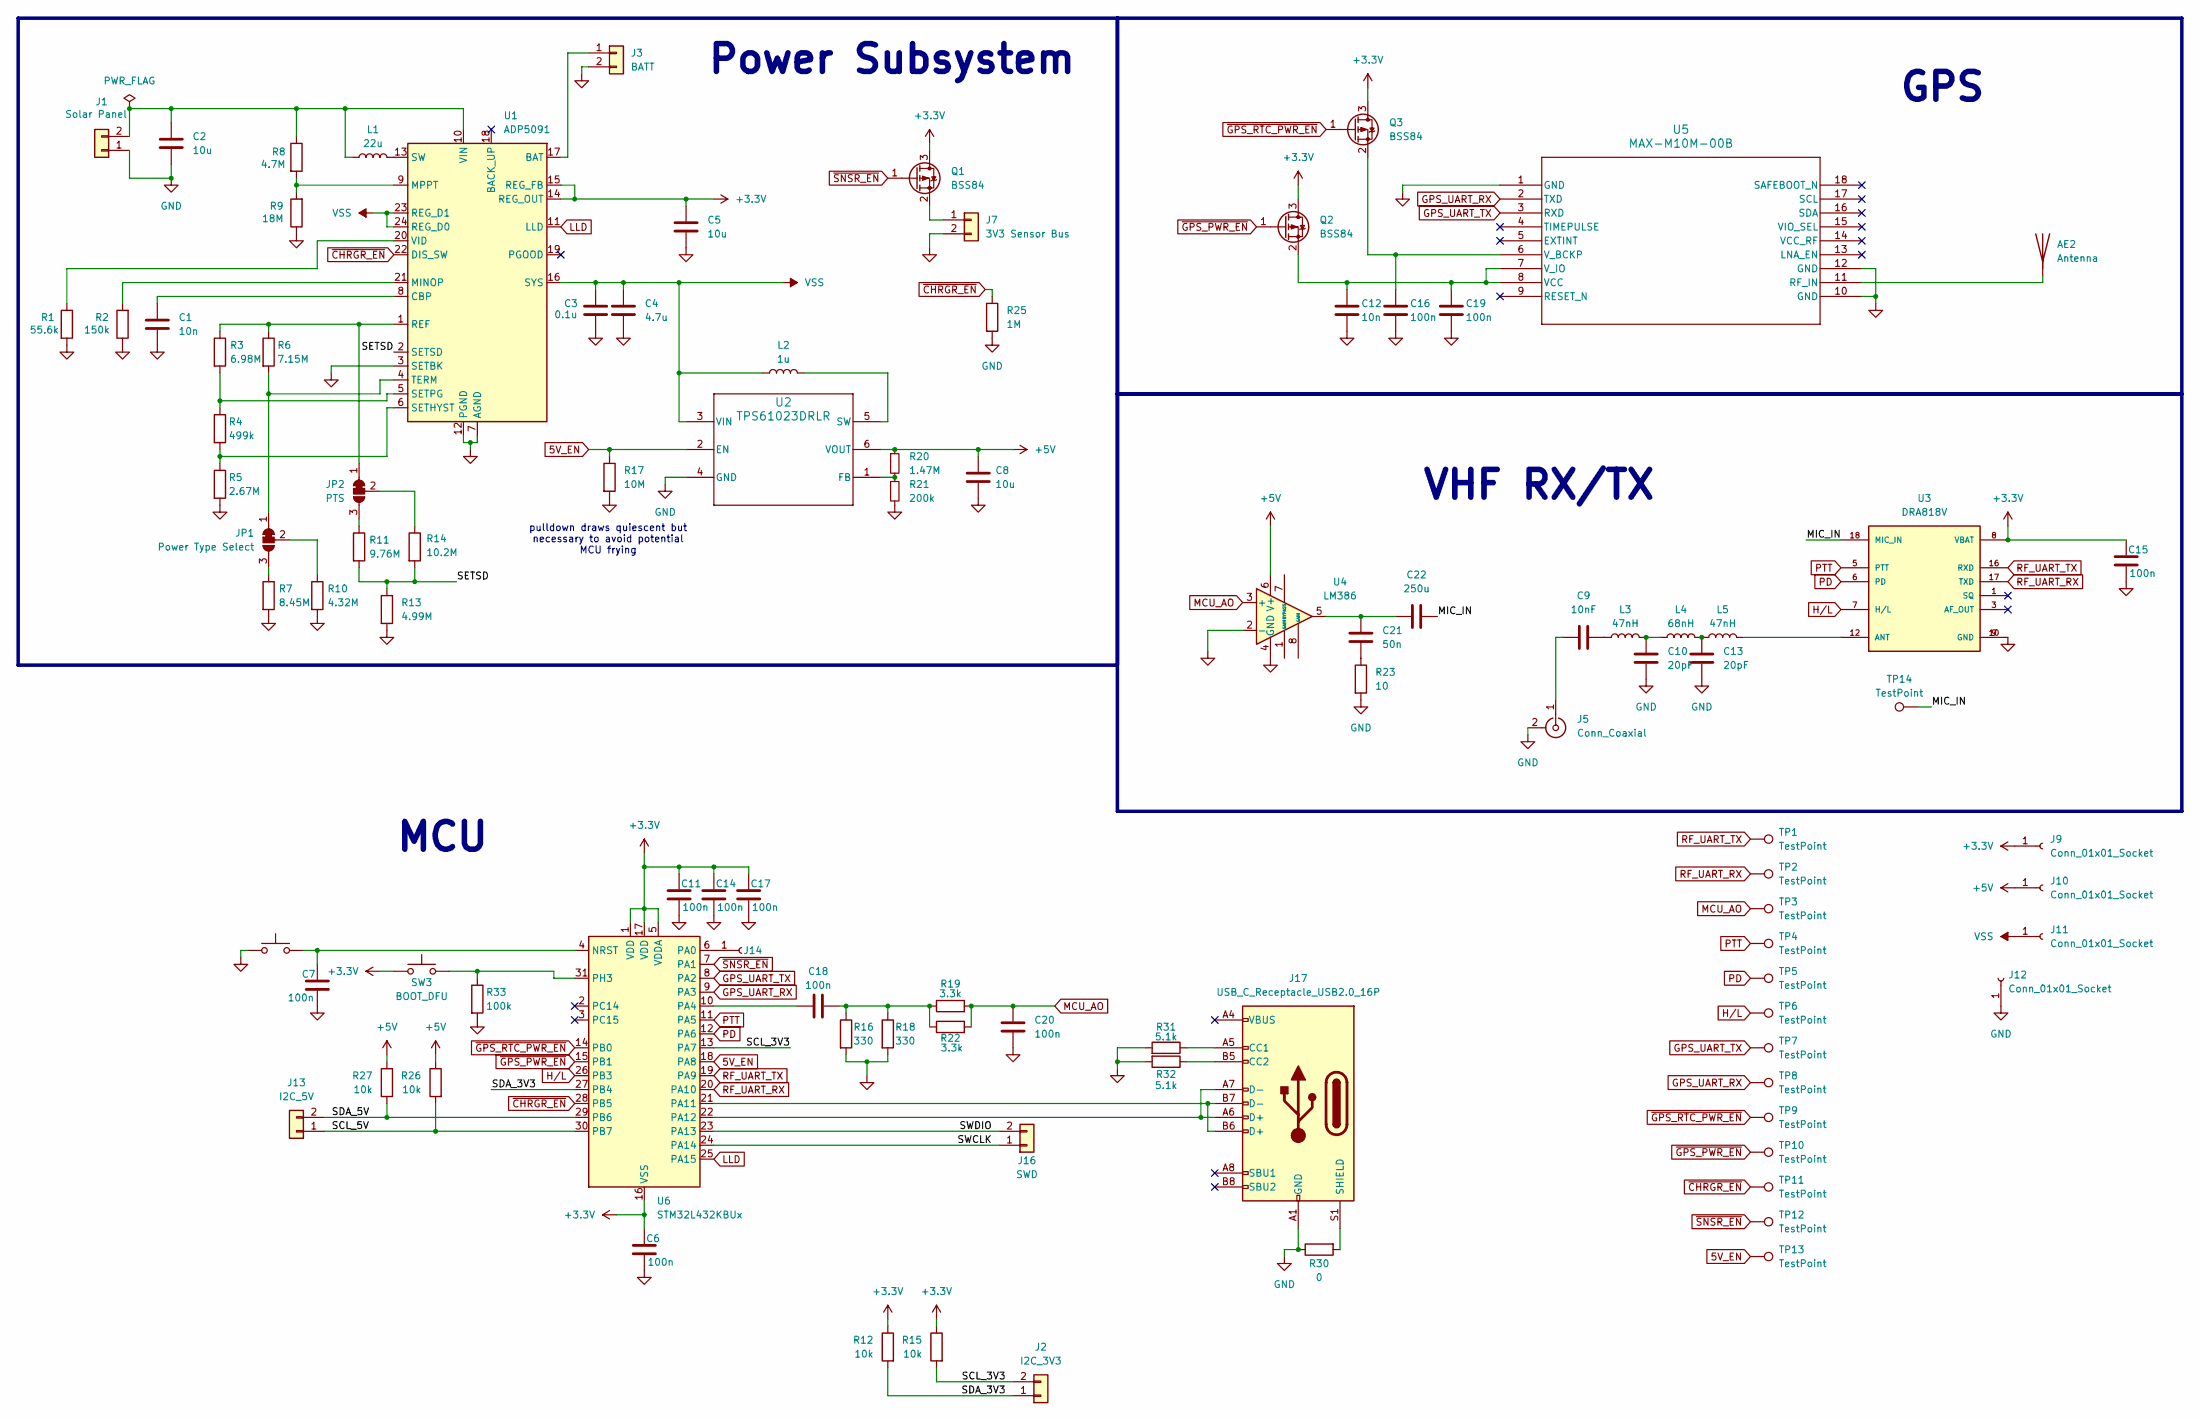
[picture p13: schematic dorji-gps.kicad_sch]

Parts:
AE2: Antenna
C1, C12: 10n
C2, C5, C8: 10u
C3: 0.1u
C4: 4.7u
C6, C7, C11, C14, C15, C16, C17, C19: 100n
C9: 10nF; C_0603_1608Metric
C10, C13: 20pF; C_0603_1608Metric
C18, C20: 100n; C_0603_1608Metric
C21: 50n; C_0603_1608Metric
C22: 250u; C_1210_3225Metric
J1: Solar Panel
J2: I2C_3V3
J3: BATT
J5: Conn_Coaxial; SMA_Molex_73251-1153_EdgeMount_Horizontal
J7: 3V3 Sensor Bus
J9, J10, J11, J12, J14: Conn_01x01_Socket
J13: I2C_5V
J16: SWD
J17: USB_C_Receptacle_USB2.0_16P
JP1: Power Type Select
JP2: PTS
L1: 22u
L2: 1u
L3, L5: 47nH; L_0603_1608Metric
L4: 68nH; L_0603_1608Metric
Q1, Q2, Q3: BSS84; SOT-23
R1: 55.6k
R2: 150k
R3: 6.98M
R4: 499k
R5: 2.67M
R6: 7.15M
R7: 8.45M
R8: 4.7M
R9: 18M
R10: 4.32M
R11: 9.76M
R12, R15, R26, R27: 10k
R13: 4.99M
R14: 10.2M
R16, R18: 330
R17: 10M
R19, R22: 3.3k; R_0603_1608Metric
R20: 1.47M
R21: 200k
R23: 10; R_0603_1608Metric
R25: 1M
R30: 0
R31, R32: 5.1k
R33: 100k
SW3: BOOT_DFU
SW4: RST
TP1, TP2, TP3, TP4, TP5, TP6, TP7, TP8, TP9, TP10, TP11, TP12, TP13, TP14: TestPoint
U1: ADP5091; LFCSP-24-1EP_4x4mm_P0.5mm_EP2.3x2.3mm
U2: TPS61023DRLR; DRL0006A
U3: DRA818V; DORJI_DRA818V; PART_REV 1.23
U4: LM386; DIP-8_W7.62mm_Socket
U5: MAX-M10M-00B; MOD18_MAX-M10M_UBL
U6: STM32L432KBUx; QFN-32-1EP_5x5mm_P0.5mm_EP3.45x3.45mm

Connections:
5V_EN: R17.1, TP13.1, U2.2 (EN), U6.18 (PA8)
+5V: C8.1, J10.1, R20.1, R26.1, R27.1, U2.6 (VOUT), U4.6 (V+)
/MIC_IN: C22.2, TP14.1, U3.18 (MIC_IN)
/SCL_3V3: J2.2, R15.2, U6.13 (PA7)
/SCL_5V: J13.1, R26.2, U6.30 (PB7)
/SDA_3V3: J2.1, R12.2, U6.27 (PB4)
/SDA_5V: J13.2, R27.2, U6.29 (PB6)
/SETSD: R11.2, R13.1, R14.2, U1.2 (SETSD)
/SWCLK: J16.1, U6.24 (PA14)
/SWDIO: J16.2, U6.23 (PA13)
GPS_UART_RX: TP8.1, U5.2 (TXD), U6.9 (PA3)
GPS_UART_TX: TP7.1, U5.3 (RXD), U6.8 (PA2)
H/L: TP6.1, U3.7 (H/L), U6.26 (PB3)
LLD: U1.11 (LLD), U6.25 (PA15)
MCU_AO: C20.2, R19.2, R22.2, TP3.1, U4.3 (+)
unnamed: C9.2, L3.1
unnamed: C10.2, L3.2, L4.1
unnamed: C13.1, L4.2, L5.1
unnamed: C18.2, R16.1, R18.1, R19.1, R22.1
unnamed: C21.1, C22.1, U4.5
unnamed: C21.2, R23.1
unnamed: C2.1, J1.2, L1.1, R8.1, U1.10 (VIN)
unnamed: J3.1, U1.17 (BAT)
unnamed 25: J17.A6 (D+), J17.A7 (D-), U6.22 (PA12); also elsewhere on the board
unnamed 26: J17.B6 (D+), J17.B7 (D-), U6.21 (PA11); also elsewhere on the board
unnamed 27: J17.S1 (SHIELD), R30.2; also elsewhere on the board
unnamed: C9.1, J5.1 (In)
unnamed: J7.1, Q1.2 (S)
unnamed: J14.1, U6.6 (PA0)
unnamed: J17.A4 (VBUS), J17.A9 (VBUS), J17.B4 (VBUS), J17.B9 (VBUS)
unnamed: J17.A5 (CC1), R31.1
unnamed: J17.B5 (CC2), R32.1
unnamed: JP1.1 (A), R6.2, U1.4 (TERM)
unnamed: JP1.3 (B), R7.1
unnamed: JP1.2 (C), R10.1
unnamed: JP2.1 (A), R3.1, R6.1, U1.1 (REF)
unnamed: JP2.3 (B), R11.1
unnamed: JP2.2 (C), R14.1
unnamed: C12.1, C19.1, Q2.2 (S), U5.7 (V_IO), U5.8 (VCC)
unnamed: C16.1, Q3.2 (S), U5.6 (V_BCKP)
unnamed: C1.1, U1.8 (CBP)
unnamed: R2.2, U1.21 (MINOP)
unnamed: R8.2, R9.2, U1.9 (MPPT)
unnamed: R4.2, R5.1, U1.6 (SETHYST)
unnamed: R3.2, R4.1, U1.5 (SETPG)
unnamed: L1.2, U1.13 (SW)
unnamed: R1.1, U1.20 (VID)
unnamed: R20.2, R21.1, U2.1 (FB)
unnamed: L2.2, U2.5 (SW)
unnamed: L5.2, U3.12 (ANT)
unnamed 52: AE2.1, U5.11 (RF_IN); also elsewhere on the board
unnamed: C7.1, SW4.1, U6.4 (NRST)
unnamed: C18.1, U6.10 (PA4)
unnamed: R33.1, SW3.1, U6.31 (PH3)
PD: TP5.1, U3.6 (PD), U6.12 (PA6)
PTT: TP4.1, U3.5 (PTT), U6.11 (PA5)
RF_UART_RX: TP2.1, U3.17 (TXD), U6.20 (PA10)
RF_UART_TX: TP1.1, U3.16 (RXD), U6.19 (PA9)
VSS: C3.1, C4.1, J11.1, L2.1, U1.16 (SYS), U1.23 (REG_D1), U1.24 (REG_D0), U2.3 (VIN)
~CHRGR_EN: R25.1, TP11.1, U1.22 (DIS_SW), U6.28 (PB5)
~GPS_PWR_EN: Q2.1 (G), TP10.1, U6.15 (PB1)
~GPS_RTC_PWR_EN: Q3.1 (G), TP9.1, U6.14 (PB0)
~SNSR_EN: Q1.1 (G), TP12.1, U6.7 (PA1)

Notes on the sheet:
GPS
VHF RX/TX
Power Subsystem
MCU
pulldown draws quiescent but necessary to avoid potential MCU frying

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
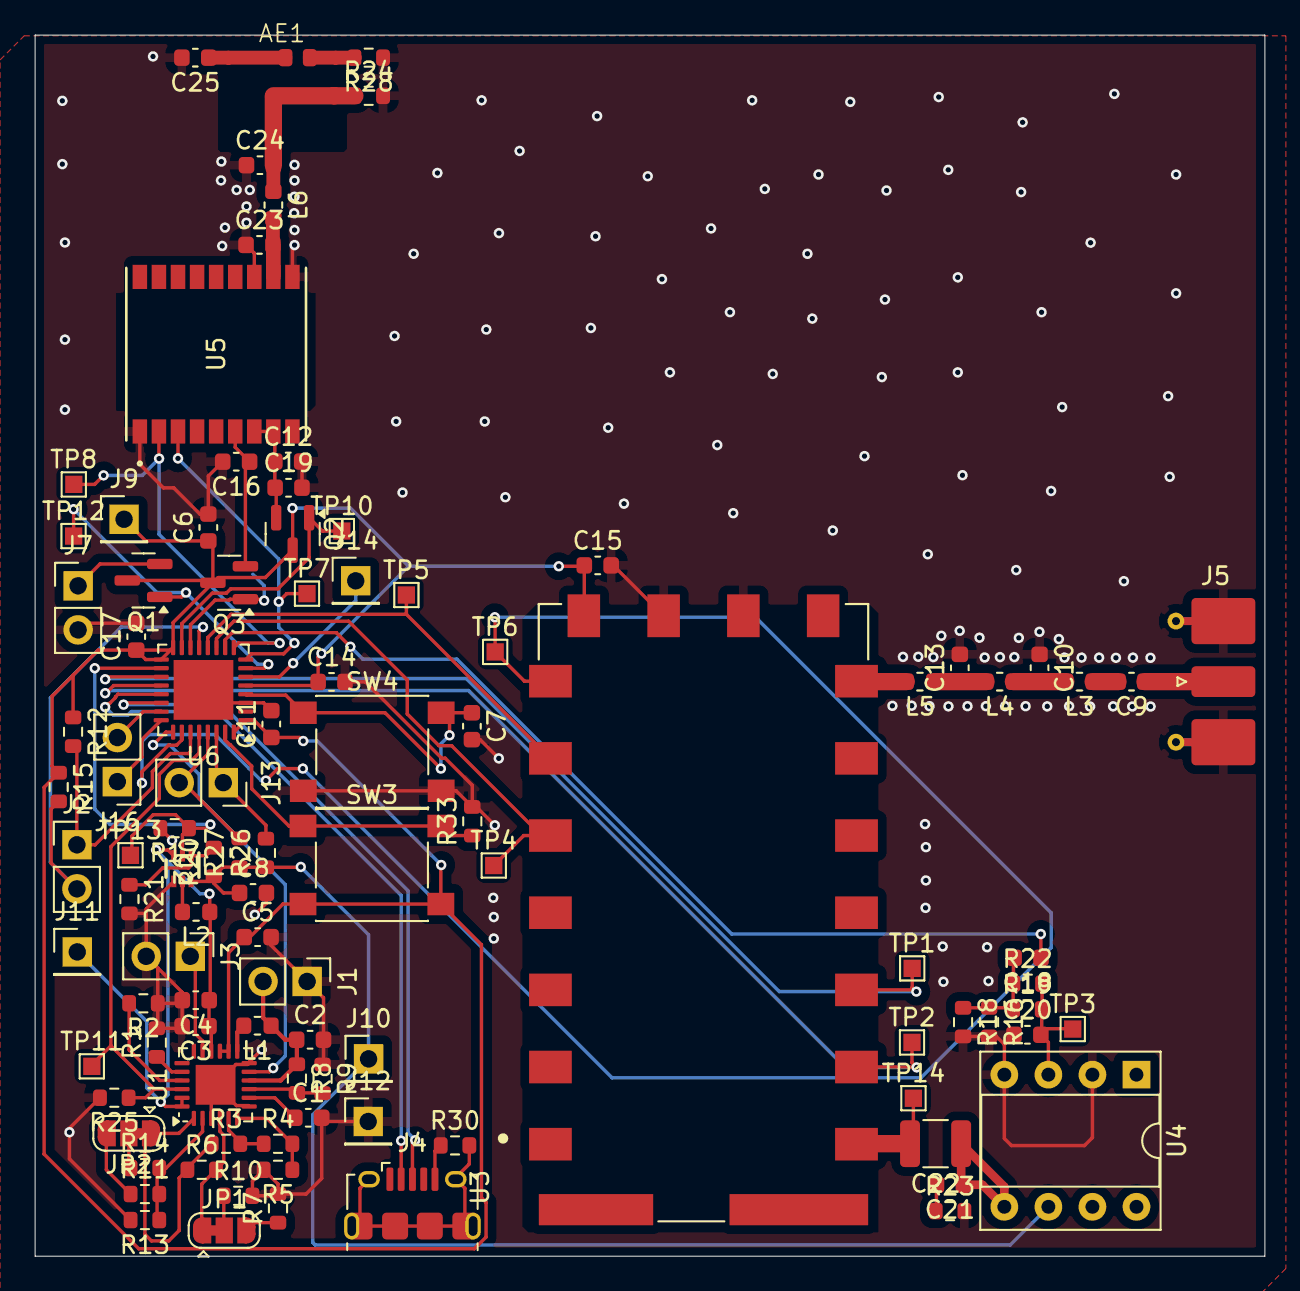
[picture p14: board dorji-gps.kicad_pcb from above]

Board: 2 copper layers, 70.9 x 70.4 mm, 102 parts (1 on the bottom side), 64 nets.

Other parts of the board:
AE1: Antenna; AC30157-01 GNSS Ceramic Chip
C23, C24: DNP; C_0603_1608Metric
C25: 10p; C_0603_1608Metric
J4: USB_B_Micro; USB_Micro-B_Amphenol_10118194-0001LF_Horizontal
L6: 2.0n; L_0603_1608Metric
R24, R28: 0; R_0603_1608Metric

Their connections:
unnamed: AE1.1 (A), C25.1, R28.2
unnamed: C24.2, L6.1, R24.1
unnamed 25: J4.3 (D+); also elsewhere on the board
unnamed 26: J4.2 (D-); also elsewhere on the board
unnamed 27: J4.6 (Shield); also elsewhere on the board
unnamed 52: C23.2, L6.2; also elsewhere on the board
