coffee-and-telesense/PicoAPRS/Firmware/STM32L4/Core/Src/main.c

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
/* Includes ------------------------------------------------------------------*/
#include "main.h"
#include "dac.h"
#include "dma.h"
#include "tim.h"
#include "usart.h"
#include "gpio.h"

/* USER CODE BEGIN Includes */
#include <math.h>
#include <stdlib.h>
#include <stdint.h>

/* USER CODE END Includes */

/* USER CODE BEGIN PD */
#define BIT_STREAM_LEN 64
#define STEPS 32
#define PERIOD 1200
#define SAMPLE_FREQ (STEPS*PERIOD)
/* USER CODE END PD */


/* USER CODE BEGIN PV */


uint8_t data[1042] = { 0, 1, 1, 1, 1, 1, 1, 0, 0, 1, 1, 1, 1, 1, 1, 0, 0, 1, 1,
		1, 1, 1, 1, 0, 0, 1, 1, 1, 1, 1, 1, 0, 0, 1, 1, 1, 1, 1, 1, 0, 0, 1, 1,
		1, 1, 1, 1, 0, 0, 1, 1, 1, 1, 1, 1, 0, 0, 1, 1, 1, 1, 1, 1, 0, 0, 1, 1,
		1, 1, 1, 1, 0, 0, 1, 1, 1, 1, 1, 1, 0, 0, 1, 1, 1, 1, 1, 1, 0, 0, 1, 1,
		1, 1, 1, 1, 0, 0, 1, 1, 1, 1, 1, 1, 0, 0, 1, 1, 1, 1, 1, 1, 0, 0, 1, 1,
		1, 1, 1, 1, 0, 0, 1, 1, 1, 1, 1, 1, 0, 0, 1, 1, 1, 1, 1, 1, 0, 0, 1, 1,
		1, 1, 1, 1, 0, 0, 1, 1, 1, 1, 1, 1, 0, 0, 1, 1, 1, 1, 1, 1, 0, 0, 1, 1,
		1, 1, 1, 1, 0, 0, 1, 1, 1, 1, 1, 1, 0, 0, 1, 1, 1, 1, 1, 1, 0, 0, 1, 1,
		1, 1, 1, 1, 0, 0, 1, 1, 1, 1, 1, 1, 0, 0, 1, 1, 1, 1, 1, 1, 0, 0, 1, 1,
		1, 1, 1, 1, 0, 0, 1, 1, 1, 1, 1, 1, 0, 0, 1, 1, 1, 1, 1, 1, 0, 0, 1, 1,
		1, 1, 1, 1, 0, 0, 1, 1, 1, 1, 1, 1, 0, 0, 1, 1, 1, 1, 1, 1, 0, 0, 1, 1,
		1, 1, 1, 1, 0, 0, 1, 1, 1, 1, 1, 1, 0, 0, 1, 1, 1, 1, 1, 1, 0, 0, 1, 1,
		1, 1, 1, 1, 0, 0, 1, 1, 1, 1, 1, 1, 0, 0, 1, 1, 1, 1, 1, 1, 0, 0, 1, 1,
		1, 1, 1, 1, 0, 0, 1, 1, 1, 1, 1, 1, 0, 0, 1, 1, 1, 1, 1, 1, 0, 0, 1, 1,
		1, 1, 1, 1, 0, 0, 1, 1, 1, 1, 1, 1, 0, 0, 1, 1, 1, 1, 1, 1, 0, 0, 1, 1,
		1, 1, 1, 1, 0, 0, 1, 1, 1, 1, 1, 1, 0, 0, 1, 1, 1, 1, 1, 1, 0, 0, 1, 1,
		1, 1, 1, 1, 0, 0, 1, 1, 1, 1, 1, 1, 0, 0, 1, 1, 1, 1, 1, 1, 0, 0, 1, 1,
		1, 1, 1, 1, 0, 0, 1, 1, 1, 1, 1, 1, 0, 0, 1, 1, 1, 1, 1, 1, 0, 0, 1, 1,
		1, 1, 1, 1, 0, 0, 1, 0, 0, 0, 0, 0, 1, 0, 0, 0, 0, 0, 1, 0, 1, 0, 0, 1,
		0, 1, 1, 0, 1, 0, 1, 0, 1, 1, 0, 0, 1, 0, 0, 0, 1, 0, 0, 0, 1, 0, 1, 0,
		1, 1, 0, 0, 1, 0, 0, 0, 0, 0, 1, 1, 0, 0, 0, 1, 1, 1, 0, 0, 1, 0, 1, 1,
		1, 1, 0, 0, 1, 0, 1, 1, 0, 0, 0, 0, 1, 0, 1, 0, 0, 0, 0, 0, 1, 0, 0, 0,
		1, 1, 0, 0, 1, 0, 0, 0, 1, 1, 0, 0, 1, 1, 1, 0, 1, 0, 1, 1, 0, 1, 1, 0,
		0, 0, 0, 0, 0, 0, 0, 0, 0, 1, 1, 1, 1, 1, 0, 0, 1, 1, 1, 1, 0, 0, 0, 0,
		0, 0, 1, 1, 0, 0, 0, 0, 0, 0, 1, 1, 0, 0, 0, 0, 0, 0, 1, 1, 0, 0, 0, 0,
		0, 0, 1, 1, 0, 0, 0, 1, 1, 1, 0, 1, 0, 0, 0, 0, 0, 0, 1, 1, 0, 0, 0, 0,
		0, 0, 1, 1, 0, 0, 0, 1, 1, 1, 0, 0, 1, 0, 1, 1, 1, 1, 0, 1, 0, 0, 0, 0,
		0, 0, 1, 1, 0, 0, 0, 0, 0, 0, 1, 1, 0, 0, 0, 0, 0, 0, 1, 1, 0, 0, 0, 0,
		0, 0, 1, 1, 0, 0, 0, 0, 0, 0, 1, 1, 0, 0, 0, 1, 1, 1, 0, 1, 0, 0, 0, 0,
		0, 0, 1, 1, 0, 0, 0, 0, 0, 0, 1, 1, 0, 0, 1, 0, 1, 0, 0, 0, 1, 0, 0, 1,
		1, 1, 1, 1, 0, 0, 0, 1, 1, 1, 1, 0, 1, 0, 0, 1, 0, 0, 0, 0, 0, 1, 0, 1,
		0, 1, 1, 1, 1, 0, 0, 0, 0, 0, 0, 1, 1, 0, 0, 0, 0, 0, 0, 1, 1, 0, 0, 0,
		0, 0, 0, 1, 1, 0, 0, 0, 0, 0, 0, 1, 1, 0, 0, 0, 0, 0, 0, 1, 1, 0, 0, 0,
		0, 0, 0, 1, 1, 0, 0, 1, 0, 0, 0, 0, 0, 1, 0, 0, 1, 0, 0, 1, 1, 1, 0, 0,
		0, 1, 0, 0, 1, 1, 0, 1, 0, 1, 0, 1, 1, 1, 0, 1, 0, 0, 1, 0, 1, 1, 0, 0,
		1, 1, 1, 0, 1, 1, 0, 1, 1, 1, 1, 0, 1, 1, 0, 0, 0, 0, 0, 0, 1, 0, 0, 1,
		0, 0, 0, 0, 0, 1, 0, 0, 0, 0, 0, 1, 0, 1, 0, 0, 1, 0, 0, 1, 0, 1, 0, 1,
		1, 0, 0, 1, 0, 1, 0, 0, 0, 0, 0, 0, 1, 0, 0, 0, 0, 1, 0, 1, 0, 1, 0, 0,
		1, 0, 0, 1, 1, 1, 0, 1, 0, 0, 0, 0, 1, 1, 0, 1, 1, 0, 0, 0, 1, 1, 0, 1,
		1, 0, 1, 0, 1, 1, 0, 1, 0, 1, 0, 0, 1, 1, 0, 0, 1, 0, 0, 1, 1, 1, 0, 0,
		0, 1, 1, 0, 0, 1, 1, 0, 0, 1, 1, 1, 0, 1, 0, 0, 1, 1, 1, 1, 1, 1, 0, 0,
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


int bufIndex = 0;
uint32_t buf[64];
uint32_t errorValue;
uint32_t sineTable[2048];
uint32_t buffer[4096];
int isrFlag = 0;
int mainFlag = 0;
/* USER CODE END PV */

void SystemClock_Config(void);
/* USER CODE BEGIN PFP */
void audioCPFSK(uint32_t *bitstream, int bitstreamLength, int samplingFreq,
		uint32_t *result);
/* USER CODE END PFP */

/**
 * @brief  The application entry point.
 * @retval int
 */
int main(void) {

	/* MCU Configuration--------------------------------------------------------*/

	/* Reset of all peripherals, Initializes the Flash interface and the Systick. */
	HAL_Init();

	/* Configure the system clock */
	SystemClock_Config();

	/* Initialize all configured peripherals */
	MX_GPIO_Init();
	MX_DMA_Init();
	MX_USART2_UART_Init();
	MX_DAC1_Init();
	MX_TIM6_Init();
	/* USER CODE BEGIN 2 */

	for (int i = 0; i < 64; i++) {
		buf[i] = data[bufIndex];
		bufIndex++;

	}

	audioCPFSK(buf, BIT_STREAM_LEN, SAMPLE_FREQ, sineTable);

	for (int i = 0; i < 2048; i++) {
		buffer[i] = sineTable[i];
	}

	HAL_TIM_Base_Start(&htim6);

	if (HAL_DAC_Start_DMA(&hdac1, DAC_CHANNEL_1, buffer, BIT_STREAM_LEN * STEPS,
			DAC_ALIGN_12B_R) == HAL_OK) {
	} else {
		errorValue = HAL_DAC_GetError(&hdac1);
	}

	/* USER CODE END 2 */

	/* Infinite loop */
	/* USER CODE BEGIN WHILE */
	while (1) {
		/* USER CODE END WHILE */
		while(mainFlag == 0){
			asm("nop");
		}
		/* USER CODE BEGIN 3 */
		switch (isrFlag) {
		case 0:

			for (int i = 0; i < 64; i++) {
				buf[i] = data[bufIndex];
				if (bufIndex >= 1041) {
					bufIndex = 0;
				} else {
					bufIndex++;
				}
			}

			audioCPFSK(buf, BIT_STREAM_LEN, SAMPLE_FREQ, sineTable);

			for (int i = 0; i < 2048; i++) {
				buffer[i] = sineTable[i];
			}

			break;
		case 1:

			for (int i = 0; i < 64; i++) {
				buf[i] = data[bufIndex];
				if (bufIndex >= 1041) {
					bufIndex = 0;
				} else {
					bufIndex++;
				}

			}

			audioCPFSK(buf, BIT_STREAM_LEN, SAMPLE_FREQ, sineTable);

			for (int i = 2048; i < 4096; i++) {
				buffer[i] = sineTable[i];
			}

			break;

		}


	}
	/* USER CODE END 3 */
}

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
/* USER CODE BEGIN 4 */

void HAL_DAC_ConvHalfCpltCallbackCh1(DAC_HandleTypeDef *hdac) {

	isrFlag = 0;


}

void HAL_DAC_ConvCpltCallbackCh1(DAC_HandleTypeDef *hdac) {
	isrFlag = 1;
	HAL_DAC_Start_DMA(&hdac1, DAC_CHANNEL_1, buffer, BIT_STREAM_LEN * STEPS, DAC_ALIGN_12B_R);
}

void audioCPFSK(uint32_t *bitstream, int bitstreamLength, int samplingFreq,
		uint32_t *result) {
	int fCenter = 1700;
	int fDelta = 500;
	int bitrate = 1200;
	int steps = samplingFreq / bitrate;
	int totalSamples = bitstreamLength * steps;
	//uint32_t dummy[16384] = {0};

	//size_t size = (totalSamples * sizeof(uint32_t));

	//uint32_t* result = (uint32_t*)malloc(size);
	// Allocate memory for the output array
	//float* y = (float*)malloc(totalSamples * sizeof(float));

	/* if(result == NULL){
	 return NULL;
	 }*/

	//Convert bitstream to NRZ format
	for (int i = 0; i < bitstreamLength; i++) {
		bitstream[i] = bitstream[i] * 2 - 1;
	}

	result[0] = 0;
	float phaseAdj = 0.0;

	for (int i = 1; i < totalSamples; i++) {
		// Interpolate the bitstream to steps points per bit
		int index = (i + steps - 1) / steps;
		int indexPrev = (i - 1 + steps - 1) / steps;

		// Integration of the bitstream with trapezoidal rule
		phaseAdj += (bitstream[indexPrev] + bitstream[index]) / 2.0;

		// FM Modulation
		result[i] = (uint32_t) (625* (1+ (cos(2 * M_PI * i* (fCenter/ (double) samplingFreq)
												- 2 * M_PI * phaseAdj* (fDelta/ (double) samplingFreq)))));

		//result[i] = ((result[i]+1) * 2047);

	}

}
/* USER CODE END 4 */
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
