coffee-and-telesense/PicoAPRS/Firmware/STM32L4 Consolodated/STM32L4 Consolodated.ioc

Mcu.UserName=STM32L432KCUx
PA0.GPIO_Label=MCO [High speed clock in]
PA0.Signal=RCC_CK_IN
PA10.Signal=USART1_RX
PA2.GPIO_Label=VCP_TX
PA2.Signal=USART2_TX
PA4.Signal=COMP_DAC11_group
PA5.Signal=GPIO_Output
PA6.Signal=GPIO_Output
PA7.Signal=GPIO_Output
PA9.Signal=USART1_TX
