coffee-and-telesense/PicoAPRS/Firmware/stmBlink/Core/Src/proto_main.c

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
/* Includes ------------------------------------------------------------------*/
#include "main.h"
#include <stdbool.h>
#include <stdio.h>
#include <string.h>
#include "stm32f0xx_hal_i2c.h"

/* USER CODE BEGIN PD */
#define AHT20_ADDR 0x38 << 1 // AHT20 I2C address (shifted for HAL compatibility)
#define AHT20_DATA_SIZE 6
#define AHT20_STATE_SIZE 1
/* USER CODE END PD */

ADC_HandleTypeDef hadc;

I2C_HandleTypeDef hi2c1;

UART_HandleTypeDef huart2;

/* USER CODE BEGIN PV */
uint8_t data[AHT20_DATA_SIZE];
uint8_t state[AHT20_STATE_SIZE];
double temperature, humidity;
int flag = 0;
/* USER CODE END PV */

void SystemClock_Config(void);
static void MX_GPIO_Init(void);
static void MX_USART2_UART_Init(void);
static void MX_ADC_Init(void);
static void MX_I2C1_Init(void);
/* USER CODE BEGIN PFP */
static void AHT20_Init(void);
static void AHT20_TriggerMeasurement(void);
static void AHT20_checkStatus(void);
static void AHT20_RecieveData(void);



/* USER CODE END PFP */

/**
  * @brief  The application entry point.
  * @retval int
  */
int main(void)
{

  /* MCU Configuration--------------------------------------------------------*/

  /* Reset of all peripherals, Initializes the Flash interface and the Systick. */
  HAL_Init();

  /* Configure the system clock */
  SystemClock_Config();

  /* Initialize all configured peripherals */
  MX_GPIO_Init();
  MX_USART2_UART_Init();
  MX_ADC_Init();
  MX_I2C1_Init();


  /* USER CODE BEGIN 2 */
  AHT20_Init();
  HAL_Delay(50);// Initialize AHT20 sensor

  /* USER CODE END 2 */

  /* Infinite loop */
  /* USER CODE BEGIN WHILE */






  while (1)
  {
    /* USER CODE END WHILE */
	 AHT20_TriggerMeasurement();
	 AHT20_RecieveData();
	 HAL_Delay(500);
    /* USER CODE BEGIN 3 */
  }
  /* USER CODE END 3 */
}


void AHT20_Init() {


    uint8_t initCmd[] = {0xBE, 0x08, 0x00}; // Initialization command
    uint8_t rstCmd[] = {0xBA, 0x08, 0x00}; // Initialization command
    HAL_I2C_Master_Transmit_IT(&hi2c1, AHT20_ADDR, rstCmd, sizeof(rstCmd));
    HAL_I2C_Master_Transmit_IT(&hi2c1, AHT20_ADDR, initCmd, sizeof(initCmd));


}

void AHT20_TriggerMeasurement() {

    uint8_t triggerCmd[] = {0xAC, 0x33, 0x00}; // Trigger measurement command
    HAL_I2C_Master_Transmit_IT(&hi2c1, AHT20_ADDR, triggerCmd, sizeof(triggerCmd));
    HAL_Delay(10);

}

//recursive status check function
void AHT20_checkStatus(){

	 	 	 uint8_t statusCmd[] = {0x71, 0x00, 0x00};
	    	 HAL_I2C_Master_Transmit_IT(&hi2c1, AHT20_ADDR, statusCmd, sizeof(statusCmd));
	    	 HAL_I2C_Master_Receive_IT(&hi2c1, AHT20_ADDR, state, AHT20_STATE_SIZE);
	    	    if(state[0] & 0x80){
	    	    	HAL_Delay(20);
	    	    	AHT20_checkStatus();
	    	    }

}

void AHT20_RecieveData(){

	HAL_I2C_Master_Receive_IT(&hi2c1, AHT20_ADDR, data, AHT20_DATA_SIZE);

}

void HAL_I2C_MasterTxCpltCallback(I2C_HandleTypeDef *hi2c1) {

    if (hi2c1->Instance == I2C1) {


    	}


}


void HAL_I2C_MasterRxCpltCallback(I2C_HandleTypeDef *hi2c1) {
	char buf[32];

    if (hi2c1->Instance == I2C1) {


    	AHT20_checkStatus(); //recursive call to check status


    	   	  uint32_t hum = (data[1] << 12) | (data[2] << 4) | (data[3] >> 4);
    	      uint32_t temp = ((data[3] & 0x0F) << 16) | (data[4] << 8) | data[5];

    	      // Convert to actual values
    	      humidity = hum * 100.0 / 0x100000;
    	      temperature = temp * 200.0 / 0x100000 - 50;


    		  sprintf(buf, "%f\r\n", humidity); // Convert float to string and store in buffer
    		  HAL_UART_Transmit(&huart2, (uint8_t*)buf, strlen(buf), 1000);
    		  sprintf(buf, "%f\r\n", temperature); // Convert float to string and store in buffer
    		  HAL_UART_Transmit(&huart2, (uint8_t*)buf, strlen(buf), 1000);
    	// Check if data is valid
    }
}



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
