coffee-and-telesense/PicoAPRS/Firmware/stmBlink/Core/Inc/sineArray.h

/*
 * sineArray.h
 *
 *  Created on: Aug 19, 2024
 *      Author: arie
 */

#ifndef INC_SINEARRAY_H_
#define INC_SINEARRAY_H_

uint16_t data[] = {  254,  160,  10,  63,  227,  219,  53,  16,  172,  252,  117,  0,  106,  249,  182,  21,  44,  211,  234,  73,  6,  149,  255,  138,  3,  83,  239,  202,  36,  28,  192,  245,  95,  1,  127,  254,  162,  11,  62,  226,  220,  54,  15,  170,  252,  118,  0,  104,  248,  183,  22,  43,  210,  234,  74,  6,  69,  165,  240,  249,  186,  90,  15,  6,  148,  255,  140,  4,  82,  238,  203,  37,  27,  190,  245,  97,  1,  126,  253,  163,  12,  61,  225,  221,  55,  14,  169,  252,  120,  0,  103,  248,  185,  23,  42,  208,  235,  76,  5,  146,  255,  142,  4,  80,  238,  205,  38,  26,  189,  246,  98,  1,  124,  253,  165,  12,  59,  224,  222,  57,  2,  22,  104,  198,  253,  233,  151,  57,  14,  167,  253,  121,  0,  101,  247,  186,  24,  41,  207,  236,  77,  5,  145,  255,  143,  5,  79,  237,  206,  40,  25,  188,  246,  100,  1,  123,  253,  166,  13,  58,  223,  223,  58,  13,  166,  253,  123,  1,  100,  246,  188,  25,  40,  206,  237,  79,  5,  143,  255,  145,  5,  77,  236,  207,  115,  29,  1,  48,  140,  226,  254,  207,  41,  24,  186,  247,  101,  0,  121,  253,  167,  14,  57,  222,  224,  59,  12,  165,  253,  124,  1,  98,  246,  189,  26,  38,  205,  238,  80,  4,  142,  255,  146,  5,  76,  235,  208,  42,  23,  185,  248,  103,  0,  120,  252,  169,  14,  55,  221,  225,  61,  12,  163,  253,  126,  1,  97,  245,  245,  175,  79,  10,  10,  80,  176,  245,  190,  27,  37,  203,  238,  82,  4,  140,  255,  148,  6,  74,  234,  210,  43,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
72,  252,  117,  0,  106,  249,  182,  21,  44,  211,  234,  73,  6,  149,  255,  138,  3,  83,  239,  202,  36,  28,  192,  245,  175,  79,  10,  10,  80,  176,  245,  245,  95,  1,  127,  254,  162,  11,  62,  226,  220,  54,  15,  170,  252,  118,  0,  104,  248,  183,  22,  43,  210,  234,  74,  6,  148,  255,  140,  4,  82,  238,  203,  37,  27,  190,  245,  97,  1,  126,  253,  163,  12,  61,  225,  221,  55,  14,  169,  252,  120,  0,  103,  248,  185,  23,  42,  208,  254,  225,  138,  47,  1,  30,  117,  208 };

#endif /* INC_SINEARRAY_H_ */
