coffee-and-telesense/PicoAPRS/Firmware/stmBlink/Core/Inc/constants.h

/*
 * constants.h
 *
 *  Created on: Aug 2, 2024
 *      Author: arie
 */

#ifndef INC_CONSTANTS_H_
#define INC_CONSTANTS_H_

#define m328p  0x01
#define m1284p 0x02
#define m644p  0x03

#define REF_3V3 0x01
#define REF_5V  0x02

#endif /* INC_CONSTANTS_H_ */
