coffee-and-telesense/PicoAPRS/Firmware/stmBlink/Core/Src/wavetable.h

/*
 * wavetable.h
 *
 *  Created on: Jul 23, 2024
 *      Author: arie
 */

#ifndef _WAVETABLE_H_
#define _WAVETABLE_H_

#define DAC_BUFFER_SIZE 128

uint32_t dac_data[DAC_BUFFER_SIZE]={1500, 1574, 1648, 1721, 1794, 1867, 1938, 2009, 2078, 2146, 2212, 2276, 2339, 2399, 2457, 2513, 2567, 2618, 2666, 2711, 2753, 2792, 2828, 2861, 2891, 2917, 2939, 2958, 2974, 2986, 2994, 2998, 2999, 2997, 2990, 2980, 2966, 2949, 2928, 2904, 2876, 2845, 2811, 2773, 2732, 2689, 2642, 2592, 2540, 2486, 2429, 2369, 2308, 2244, 2179, 2112, 2043, 1974, 1903, 1831, 1758, 1685, 1611, 1537, 1462, 1388, 1314, 1241, 1168, 1096, 1025, 956, 887, 820, 755, 691, 630, 570, 513, 459, 407, 357, 310, 267, 226, 188, 154, 123, 95, 71, 50, 33, 19, 9, 2, 0, 1, 5, 13, 25, 41, 60, 82, 108, 138, 171, 207, 246, 288, 333, 381, 432, 486, 542, 600, 660, 723, 787, 853, 921, 990, 1061, 1132, 1205, 1278, 1351, 1425, 1499};


#endif /* SRC_WAVETABLE_H_ */
