coffee-and-telesense/PicoAPRS/(commit log)

2024-09-12 clean gerbers
    [rf-frontend-test-B_Cu.gbr, rf-frontend-test-B_Mask.gbr, rf-frontend-test-B_Paste.gbr, rf-frontend-test-Edge_Cuts.gbr, rf-frontend-test-F_Cu.gbr, rf-frontend-test-F_Mask.gbr, rf-frontend-test-F_Paste.gbr, rf-frontend-test-NPTH.drl]
2024-09-12 clean sch
    [Power.kicad_sch]
2024-09-12 clean sch2
    [rf-frontend-test.kicad_pcb, rf-frontend-test.kicad_sch]
2024-09-14 gnss board
    [gnss-test.kicad_pcb, gnss-test.kicad_sch]
2024-09-14 powerTest files
    [Power.kicad_sch, firmware-edition.kicad_pcb, firmware-edition.kicad_sch, powerTest.kicad_pcb, powerTest.kicad_sch]
2024-09-14 fix structure
    [Power.kicad_sch, firmware-edition.kicad_pcb, firmware-edition.kicad_sch, powerTest.kicad_pcb, powerTest.kicad_sch]
2024-09-14 remove extra files
    [Power.kicad_sch, firmware-edition.kicad_pcb, firmware-edition.kicad_sch]
2024-10-03 dorji payload files
    [payloadDorji.kicad_pcb, payloadDorji.kicad_sch]
2024-10-04 dorji edition board
    [dorji-gps.kicad_pcb, dorji-gps.kicad_sch]
2024-10-04 DRA818V symbol and footprint
2024-10-07 the layout doesn't work in the alser
    [dorji-gps.kicad_pcb]
2024-10-09 payloadDorji add gps and power
    [payloadDorji.kicad_sch]
2024-10-14 some fixes, not done yet
    [payloadDorji.kicad_pcb, payloadDorji.kicad_sch]
2024-10-15 no blow up
    [payloadDorji.kicad_pcb, payloadDorji.kicad_sch]
2024-10-21 mounting holes, vias, etc
    [payloadDorji.kicad_pcb, payloadDorji.kicad_sch]
2024-10-21 kiCAD cleanup! Added .gitignore file, removed temporary files from git, fixed library paths to be relative, cleaned up schematic errors, cleaned up layout errors, cleaned up consistency between sch/b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
    [payloadDorji.kicad_pcb, payloadDorji.kicad_sch]
2024-10-21 restructured git repo. .Sym files are located in the symbols dir. footprints in the picoaprs.pretty dir within the symbols dir
2024-10-22 Fixed library paths. Add PICOAPRS_LIBRARIES to your project variables which points to the kicad/lib directory. Also fixed up schematic to be more readable, and fixed some more issues between sch/brd.
    [payloadDorji.kicad_pcb, payloadDorji.kicad_sch]
2024-10-22 ublox symbol
    [gnss-test-B_Cu.gbr, gnss-test-B_Mask.gbr, gnss-test-Edge_Cuts.gbr, gnss-test-F_Cu.gbr, gnss-test-F_Mask.gbr, gnss-test-NPTH-drl.gbr, gnss-test-PTH-drl.gbr, gnss-test-job.gbrjob]
2024-10-22 Fixed GPS symbol (blech) and found two misconnected pins. Fixed in shcematic and layout.
    [payloadDorji.kicad_pcb, payloadDorji.kicad_sch]
2024-10-22 Fix final missing footprints! OK, NOW everything is fixed.
    [payloadDorji.kicad_pcb, payloadDorji.kicad_sch]
2024-12-05 working arduino example for GPS. Runs on dorjiPayload layout
    [u-blox_config_keys_sorted.txt]
2025-01-17 Delete Firmware/stmBlink/Core/Inc/device.h
    its fucked
2025-01-24 Power Board Test 1.1
    Updated Test Power Board
    [powerTest.kicad_pcb, powerTest.kicad_sch]
2025-02-12 power test resistor change
    [powerTest.kicad_sch]
2025-02-12 Si4463 Transceiver Circuit V2.
    Updated the transceiver board to make it compliant with EPL fab limitations. Fixed all GND vias, added Header Pins for the GPIO pins
    [rf-frontend-test.kicad_pcb, rf-frontend-test.kicad_sch]
2025-02-16 move some vias on rf frontend test board
    [rf-frontend-test.kicad_pcb]
2025-02-16 reroute rf_en on rf frontend test for assembly ease
    [rf-frontend-test.kicad_pcb]
2025-02-17 slight value changes to rf frontend
    [rf-frontend-test.kicad_pcb, rf-frontend-test.kicad_sch]
2025-02-19 GNSS board V2
    This new board is a review of the pre existing GNSS circuitry used with the Dorji circuit. Fixed all DRC errors and implemented via snitching compatible with EPL Fab constraints.
    [gnss-test.kicad_pcb]
2025-02-19 GNSS V2.1
    Fixed footprint of antenna
    [gnss-test.kicad_pcb]
2025-03-05 kicad 9.0 updates
    [firmware-edition.kicad_sch, gnss-test.kicad_pcb, gnss-test.kicad_sch]
2025-04-11 BOM of second Transceiver board
    BOM of second Transceiver board
    [rf-frontend-test.kicad_sch]
2025-04-18 bring updated boards into final design
    [firmware-edition.kicad_sch]
2025-04-18 update GPS to I2C
    [firmware-edition.kicad_sch]
2025-04-20 PCB layout of System Board v1.01
    [firmware-edition.kicad_pcb, firmware-edition.kicad_sch, gnss-test.kicad_pcb, powerTest.kicad_pcb]
2025-04-23 Finished PCB layoiut of Integration board V1.01
    [firmware-edition.kicad_pcb, firmware-edition.kicad_sch]
2025-04-23 slight changes to mainboard, rf0603 layout
    [firmware-edition.kicad_pcb, gnss-test.kicad_pcb, gnss-test.kicad_sch, rf-frontend-test.kicad_pcb, rf-frontend-test.kicad_sch, rf-frontend-test2.kicad_pcb, rf-panel.kicad_pcb]
2025-04-28 improved layout, added PGOOD to MCU connection
    [firmware-edition.kicad_pcb, firmware-edition.kicad_sch]
2025-05-17 Integration Board V3
    Replaced USB C receptacle with Pinout for breakout board, Solved all thermal issues, VSS = GND for STM microcontroller, updated transceiver module to 0603 pads for RLC components
    [firmware-edition.kicad_pcb, firmware-edition.kicad_sch]
2025-05-17 USB C Breakout boards inhouse
    Breakout boards for usb C 2.0
    [USBC_Breakoutboard.kicad_pcb, USBC_Breakoutboard.kicad_sch, firmware-edition.kicad_pcb]
2025-05-19 main board updates, stm breakout
    [firmware-edition.kicad_pcb, firmware-edition.kicad_sch, stm32u073-breakout.kicad_pcb, stm32u073-breakout.kicad_sch]
2025-05-22 Integration Boards V3.5
    Fixed places prone to shorts and started adding header labels and fixing component labels on the silkscreen layer
    [firmware-edition.kicad_pcb]
2025-05-30 Silscreen layer fixed
    Last Integrtion board V5
    [firmware-edition.kicad_pcb]
2025-05-30 via stitch updates
    [firmware-edition.kicad_pcb, firmware-edition.kicad_sch]
2025-05-30 Fixed small issues
    [firmware-edition.kicad_pcb, firmware-edition.kicad_sch]
2025-06-03 rev b final JLC
    [firmware-edition.kicad_pcb]
2025-06-20 transistors backwards
    [firmware-edition.kicad_pcb, firmware-edition.kicad_sch]
