coffee-and-telesense/PicoAPRS/(notices)

Notices in the files:
Firmware/STM32L4/Core/Inc/main.h:
Copyright (c) 2024 STMicroelectronics.
All rights reserved.
This software is licensed under terms that can be found in the LICENSE file
